rokoter/cv-monitor/docs/jlc_preview_controle_rev0.2.png

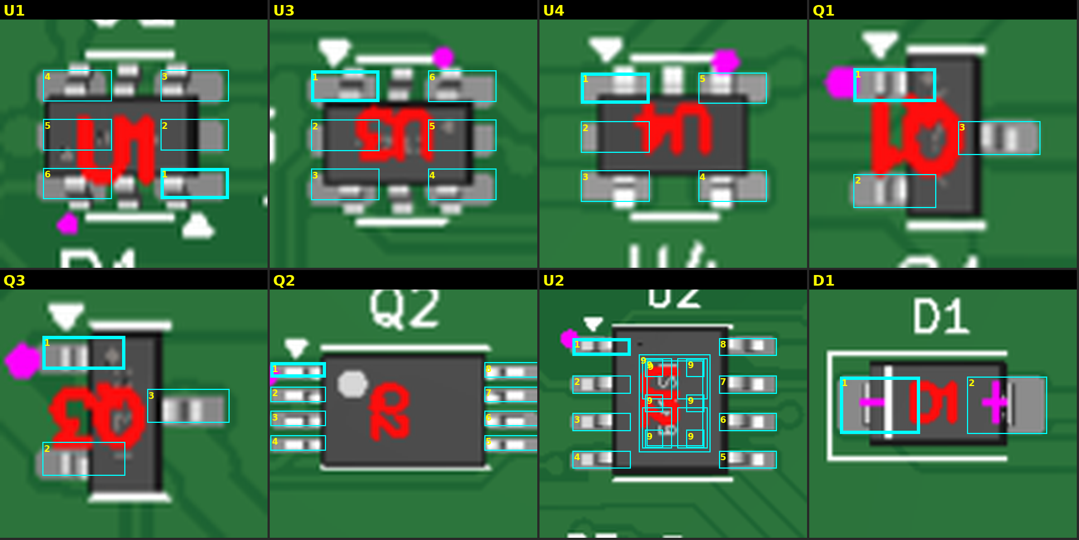
docs/jlc_preview_controle_rev0.2.png
