rokoter/cv-monitor/docs/routing_rapport_rev0.2.txt

net                  lengte   min  via  lagen
VBUS                 152.7mm  0.50    4  B.Cu,F.Cu
EN                   130.6mm  0.20    2  B.Cu,F.Cu
BAT+                 116.5mm  0.80    4  B.Cu,F.Cu
BOOT                 107.0mm  0.20    2  B.Cu,F.Cu
I2C_SCL               94.7mm  0.20    2  B.Cu,F.Cu
I2C_SDA               94.2mm  0.20    4  B.Cu,F.Cu
USB_D+                92.7mm  0.20    4  B.Cu,F.Cu
KNOP                  91.0mm  0.20    2  B.Cu,F.Cu
USB_D-                88.1mm  0.20    4  B.Cu,F.Cu
CELL+                 87.3mm  0.80    1  B.Cu,F.Cu
UART_TX               62.0mm  0.20    0  F.Cu
UART_RX               61.6mm  0.20    2  B.Cu,F.Cu
VSYS                  59.4mm  0.60    0  F.Cu
EXP_GPIO7             49.8mm  0.20    2  B.Cu,F.Cu
DQ_RETOUR             49.8mm  0.20    2  B.Cu,F.Cu
VBAT_SENSE            48.9mm  0.20    2  B.Cu,F.Cu
EXP_GPIO6             46.6mm  0.20    2  B.Cu,F.Cu
TEMP                  44.4mm  0.20    2  B.Cu,F.Cu
DQ_AANVOER            43.4mm  0.20    2  B.Cu,F.Cu
B-                    43.0mm  0.40    1  B.Cu,F.Cu
GND                   41.5mm  0.40   38  B.Cu,F.Cu
EPD_CLK               40.1mm  0.20    0  F.Cu
VBUS_SENSE            34.4mm  0.20    2  B.Cu,F.Cu
Net-(D3-K)            32.0mm  0.20    2  B.Cu,F.Cu
Net-(D2-K)            31.2mm  0.20    2  B.Cu,F.Cu
EPD_BUSY              30.1mm  0.20    1  B.Cu,F.Cu
EPD_RST               27.1mm  0.20    1  B.Cu,F.Cu
EPD_DC                25.6mm  0.20    2  B.Cu,F.Cu
EXP_GPIO18            23.5mm  0.20    0  F.Cu
EXP_GPIO17            22.8mm  0.20    0  F.Cu
EPD_CS                19.6mm  0.20    0  F.Cu
+3V3                  17.2mm  0.40   16  F.Cu
CC1                   15.3mm  0.20    0  F.Cu
Net-(U2-PROG)         15.2mm  0.20    2  B.Cu,F.Cu
VBUS_IN               15.1mm  0.50    0  F.Cu
CC2                   15.1mm  0.20    0  F.Cu
EPD_DIN               14.1mm  0.20    0  F.Cu
DW_VCC                13.1mm  0.20    2  B.Cu,F.Cu
DW_OC                 11.8mm  0.20    0  F.Cu
Net-(J2-Pin_2)        10.7mm  0.20    0  F.Cu
Net-(J3-Pin_2)        10.3mm  0.20    0  F.Cu
LED_STATUS            10.3mm  0.20    0  F.Cu
Net-(D4-A)             8.4mm  0.20    0  F.Cu
Net-(D5-A)             8.0mm  0.20    0  F.Cu
DW_OD                  7.2mm  0.20    0  F.Cu
unconnected-(Q2-D-Pad1)     5.7mm  0.20    0  F.Cu
Net-(Q3-G)             5.6mm  0.20    0  F.Cu
DW_CS                  5.1mm  0.20    0  F.Cu
Net-(D6-K)             4.8mm  0.20    0  F.Cu
Net-(D2-A)             4.6mm  0.20    0  F.Cu
Net-(D3-A)             4.6mm  0.20    0  F.Cu
Net-(JP1-A)            2.5mm  0.20    0  F.Cu

112 via's, 2096 mm spoor
info: VSYS: 0.60 mm over 1.8 mm (versmalling bij pin)
info: VSYS: 0.60 mm over 1.8 mm (versmalling bij pin)
info: VSYS: 0.60 mm over 0.0 mm (versmalling bij pin)
info: VSYS: 0.60 mm over 0.1 mm (versmalling bij pin)
info: VBUS: 0.60 mm over 0.5 mm (versmalling bij pin)
info: VBUS: 0.60 mm over 0.9 mm (versmalling bij pin)
info: VBUS: 0.50 mm over 1.0 mm (versmalling bij pin)
CONTROLE: in orde
