rokoter/cv-monitor/docs/gerber_controle_boven_rev0.2.png

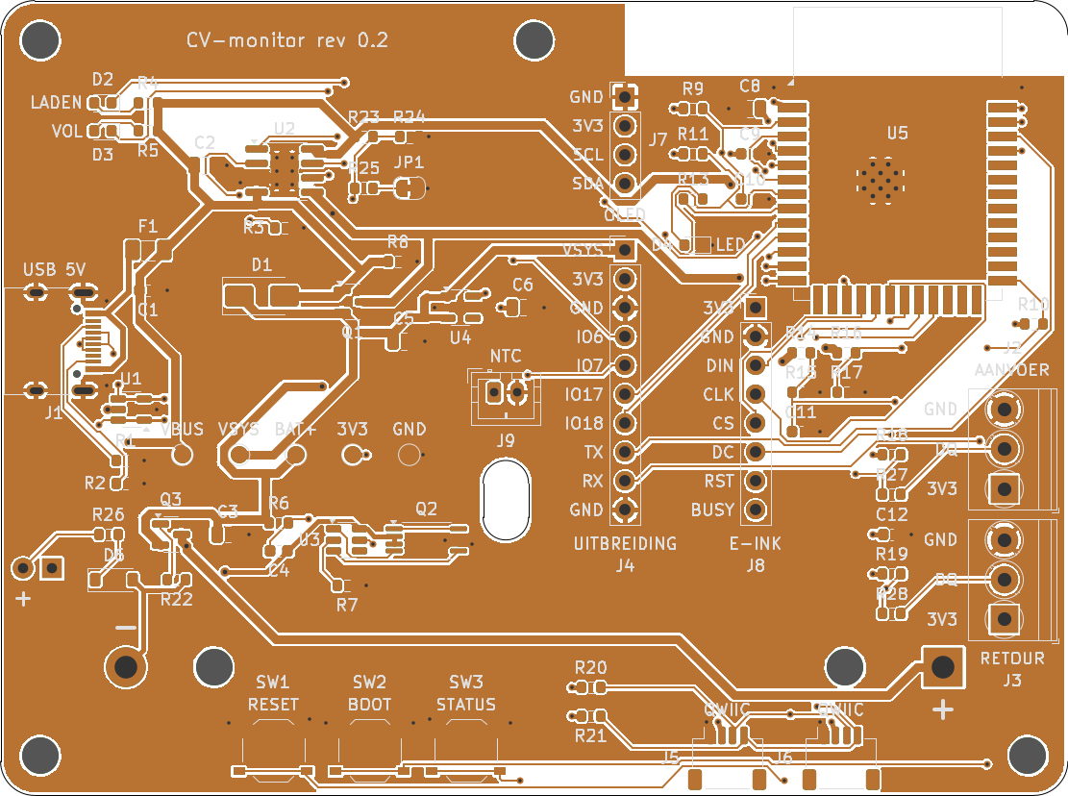
docs/gerber_controle_boven_rev0.2.png
