rokoter/cv-monitor/docs/gerber_controle_onder_rev0.2.png

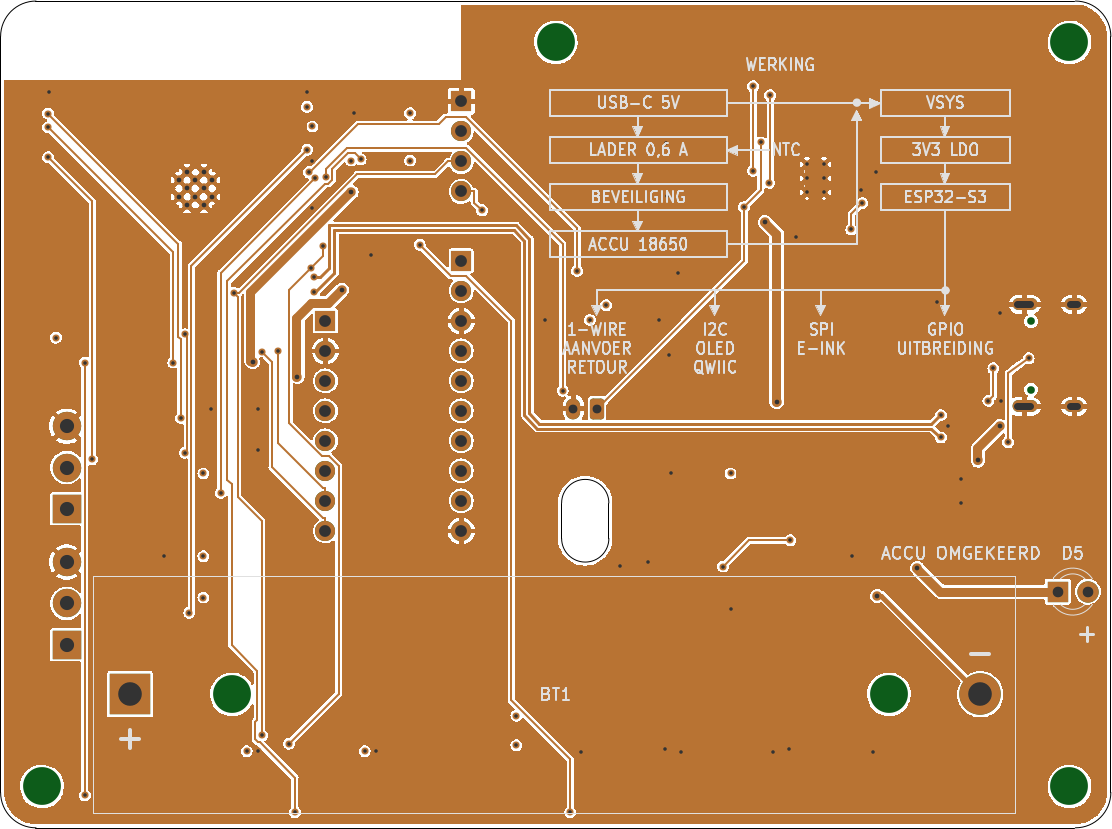
docs/gerber_controle_onder_rev0.2.png
