rokoter/cv-monitor/docs/pcb_3d_boven_rev0.2.png

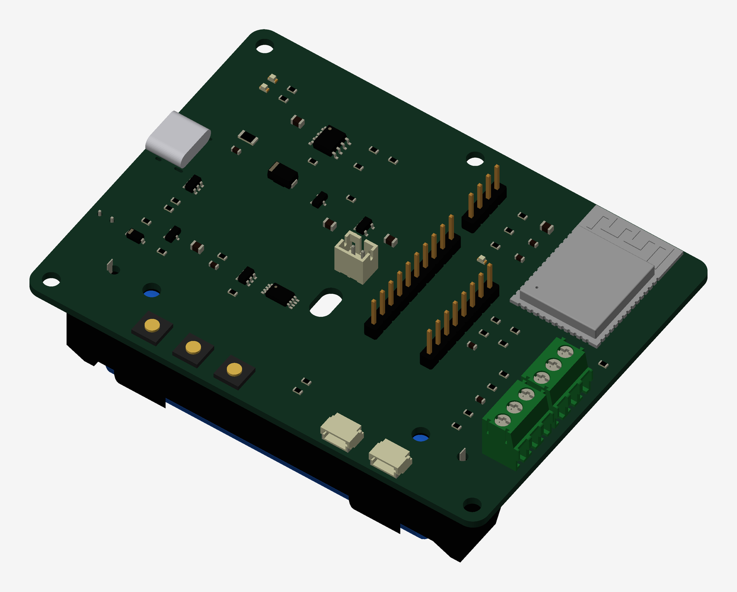
docs/pcb_3d_boven_rev0.2.png
