rokoter/cv-monitor/docs/pcb_3d_onder_rev0.2.png

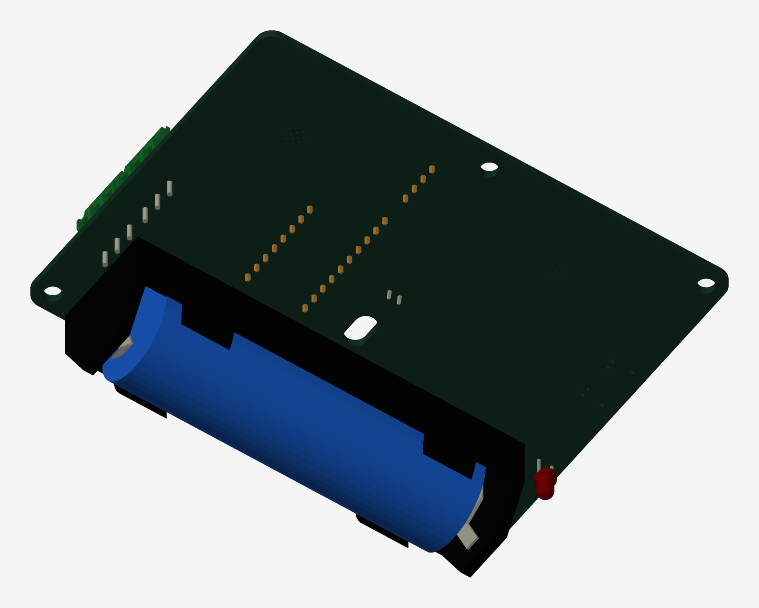
docs/pcb_3d_onder_rev0.2.png
