rokoter/cv-monitor/docs/pcb_achterkant_blokschema_rev0.2.png

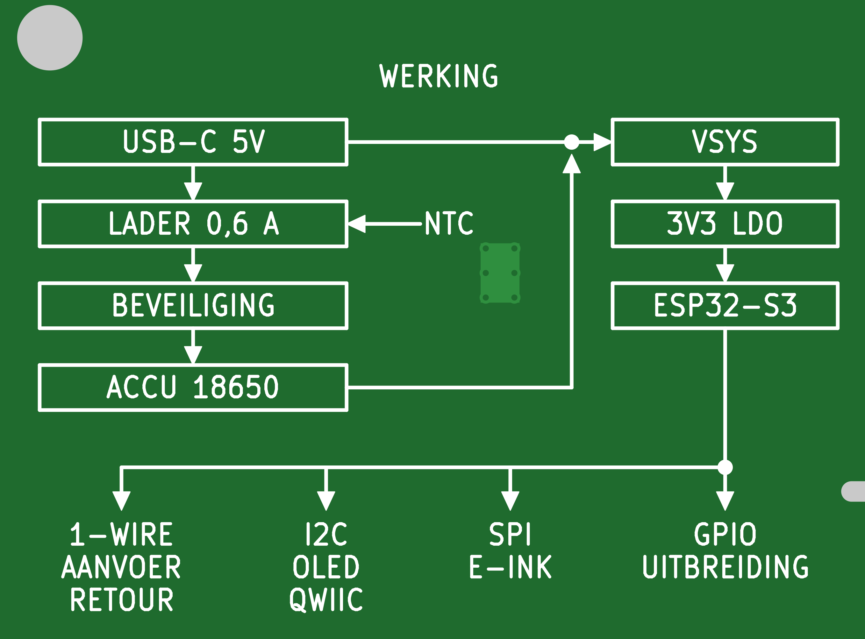
docs/pcb_achterkant_blokschema_rev0.2.png
