rokoter/cv-monitor/docs/pcb_plaatsing_rev0.2.png

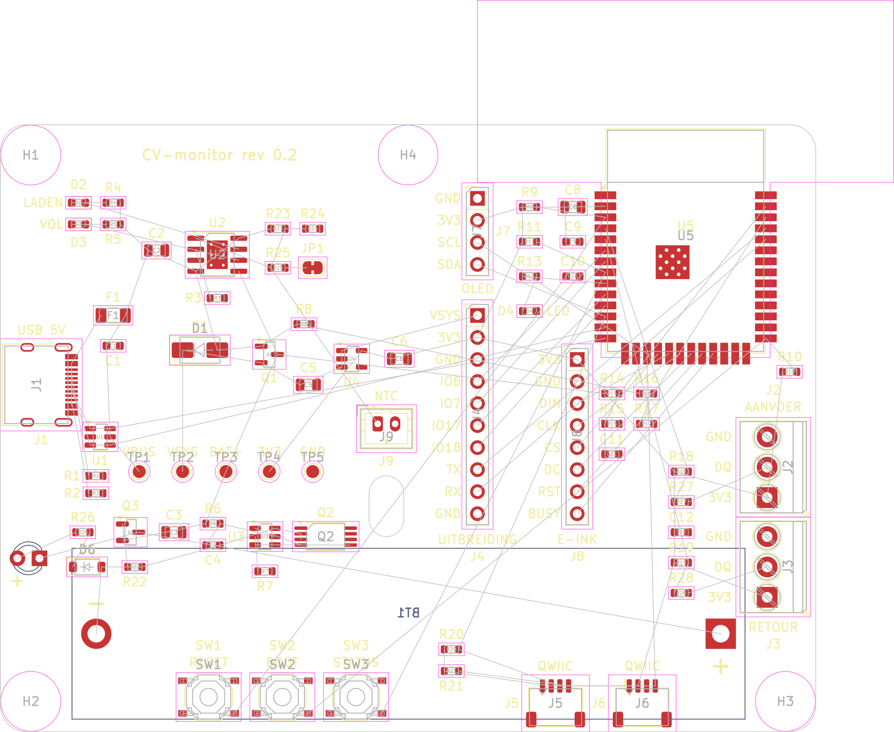
docs/pcb_plaatsing_rev0.2.png
