rokoter/cv-monitor/docs/pcb_preview_boven_rev0.2.png

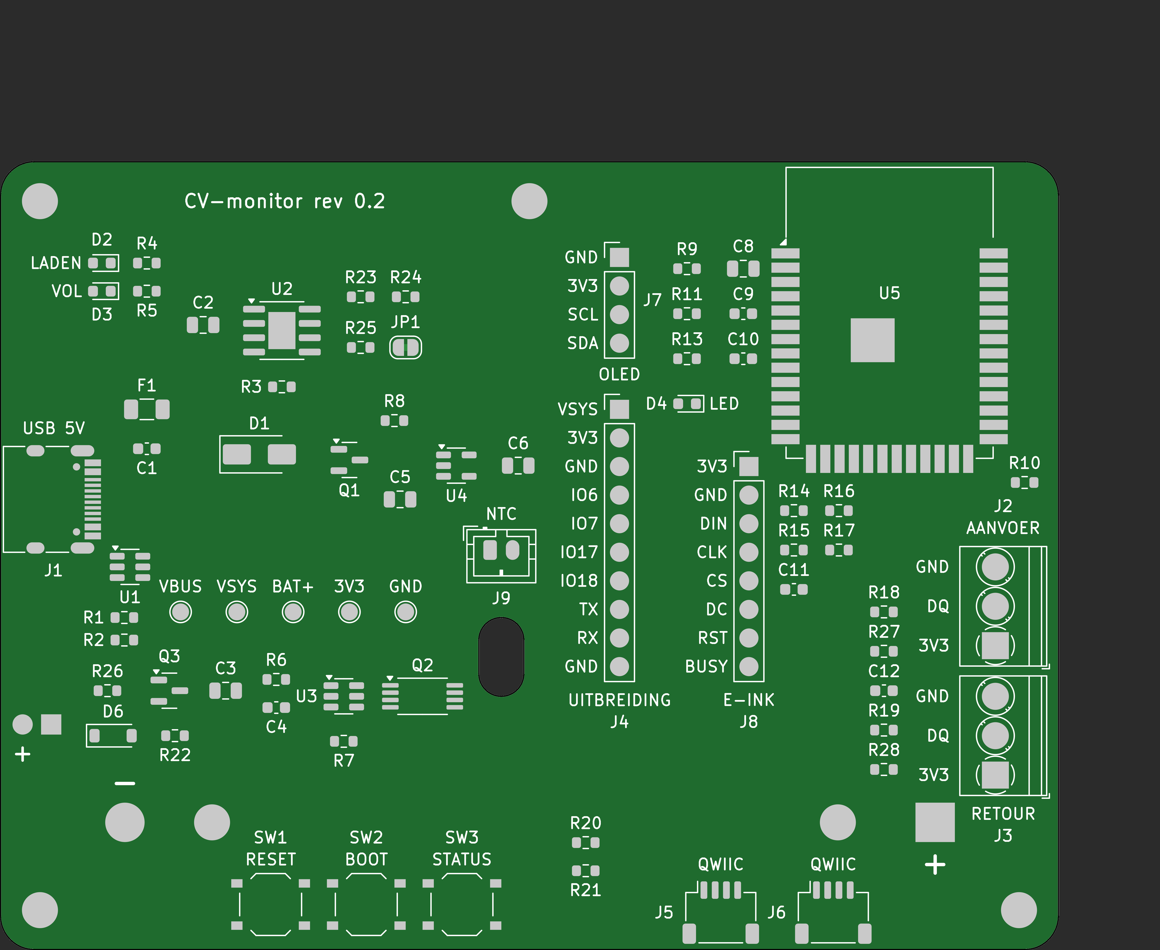
docs/pcb_preview_boven_rev0.2.png
