rokoter/cv-monitor/docs/pcb_preview_onder_rev0.2.png

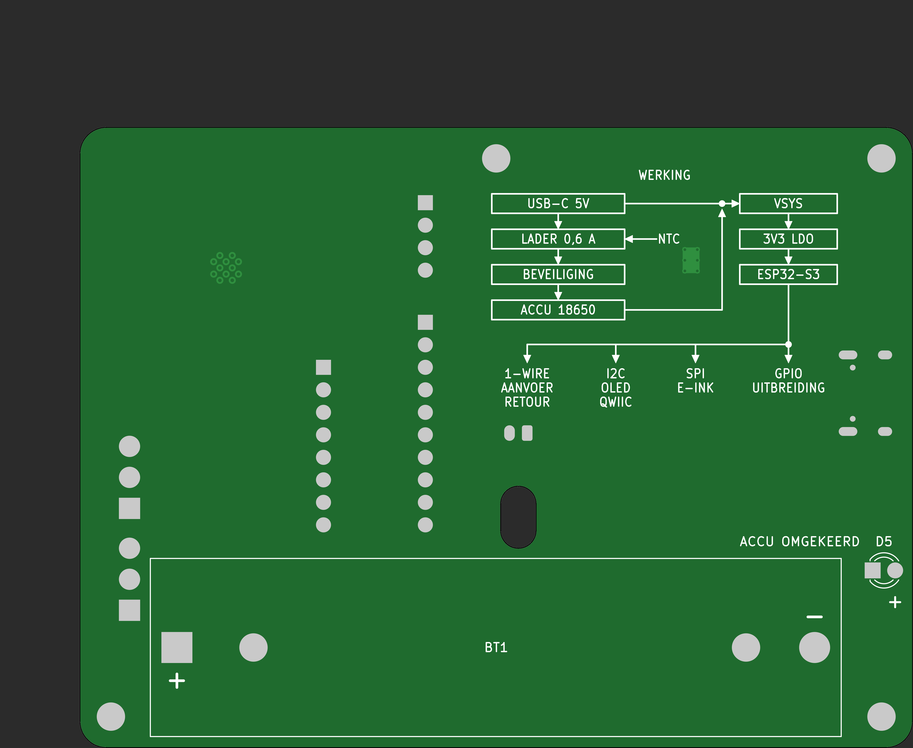
docs/pcb_preview_onder_rev0.2.png
