rokoter/cv-monitor/docs/pcb_routing_boven_rev0.2.png

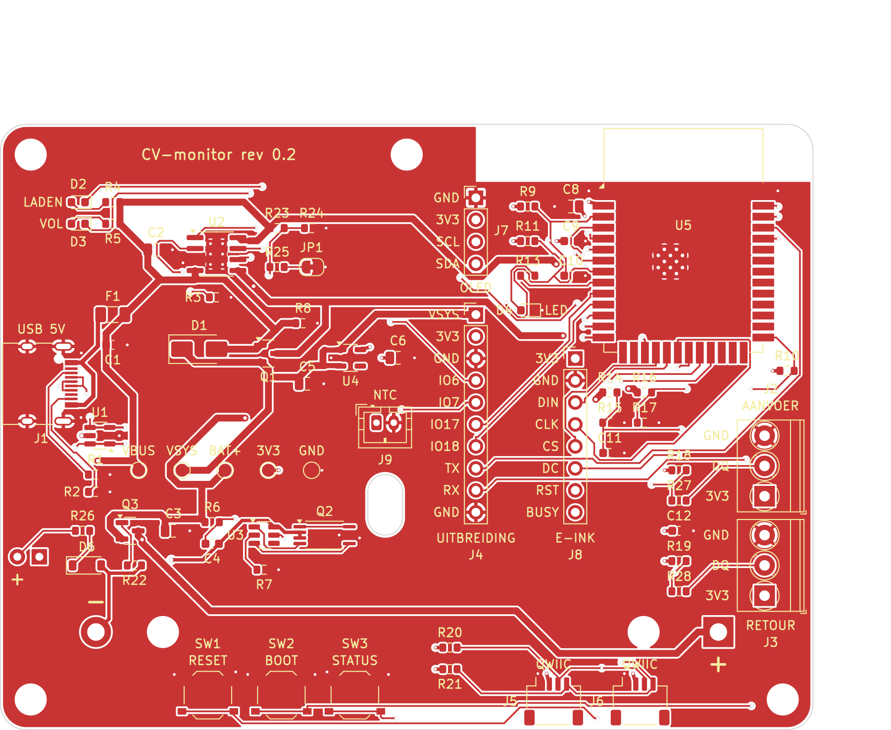
docs/pcb_routing_boven_rev0.2.png
