rokoter/cv-monitor/docs/pcb_routing_in1_gnd_rev0.2.png

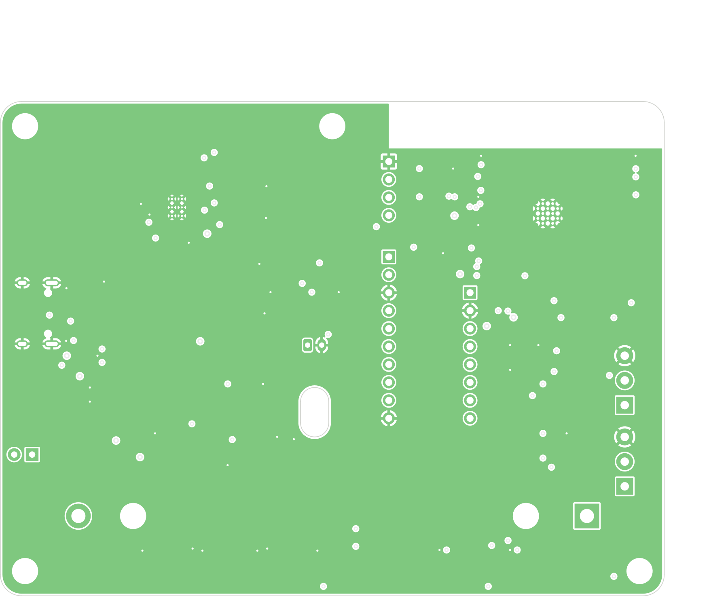
docs/pcb_routing_in1_gnd_rev0.2.png
