rokoter/cv-monitor/docs/pcb_routing_in2_3v3_rev0.2.png

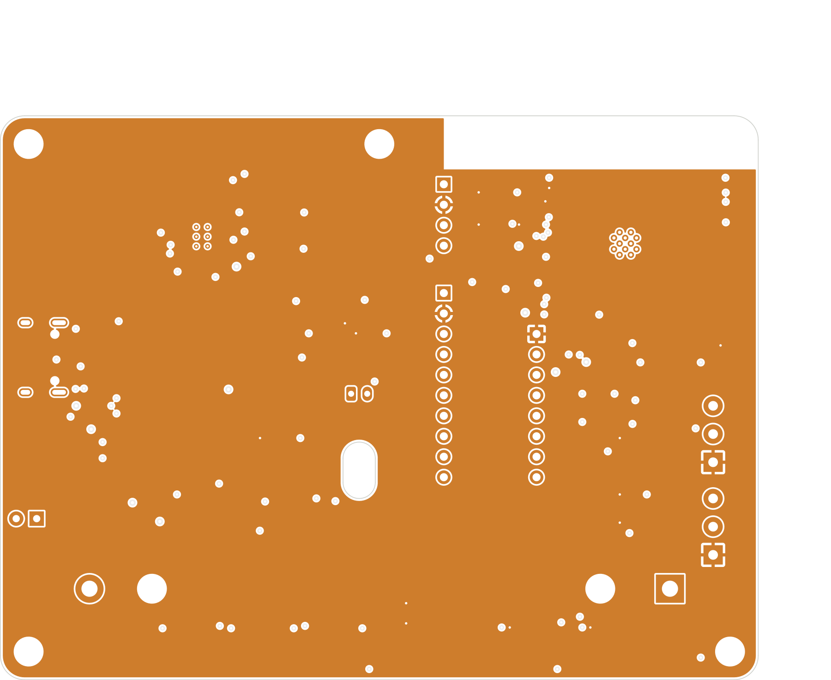
docs/pcb_routing_in2_3v3_rev0.2.png
