rokoter/cv-monitor/docs/pcb_usb_paar_onderkant_rev0.2.png

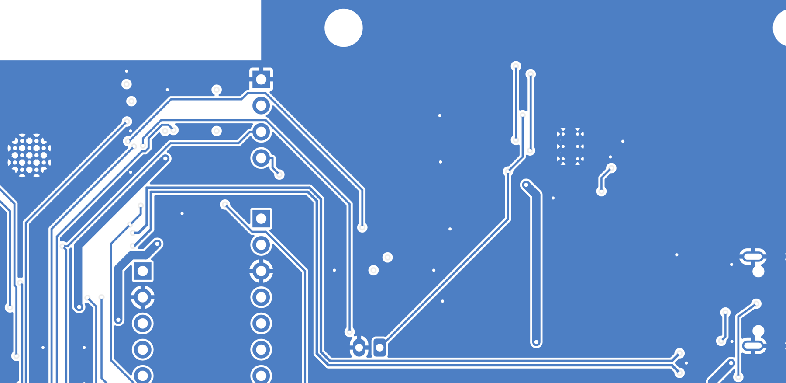
docs/pcb_usb_paar_onderkant_rev0.2.png
