rokoter/cv-monitor/hardware/cv_monitor/production/cv_monitor_rev0.2_bom.csv

Comment | Designator | Footprint | LCSC Part #
1uF | C1,C10 | C_0603_1608Metric | C15849
10uF | C2,C3,C5,C6 | C_0805_2012Metric | C15850
100nF | C4,C9,C11,C12 | C_0603_1608Metric | C14663
22uF | C8 | C_0805_2012Metric | C45783
SS34 | D1 | D_SMA | C8678
rood: laden | D2 | LED_0603_1608Metric | C2286
groen: vol | D3 | LED_0603_1608Metric | C12624
geel: status | D4 | LED_0603_1608Metric | C89811
1N4148W | D6 | D_SOD-123 | C81598
1,1A PTC | F1 | Fuse_1206_3216Metric | C269119
USB-C | J1 | USB_C_Receptacle_HRO_TYPE-C-31-M-12 | C165948
QWIIC 1 / QWIIC 2 | J5,J6 | JST_SH_SM04B-SRSS-TB_1x04-1MP_P1.00mm_Horizontal | C160404
AO3401A | Q1,Q3 | SOT-23 | C15127
AO8810 (8205A-compatibel) | Q2 | TSSOP-8_4.4x3mm_P0.65mm | C21426
5.1k | R1,R2 | R_0603_1608Metric | C23186
2k | R3 | R_0603_1608Metric | C22975
1k | R4,R7,R8,R13,R26 | R_0603_1608Metric | C21190
4.7k | R5,R18,R19,R20,R21,R23 | R_0603_1608Metric | C23162
100R | R6,R27,R28 | R_0603_1608Metric | C22775
10k | R9,R10,R11,R22,R25 | R_0603_1608Metric | C25804
100k | R14,R15,R16,R17 | R_0603_1608Metric | C25803
47k | R24 | R_0603_1608Metric | C25819
RESET / BOOT / STATUS | SW1,SW2,SW3 | SW_Push_1P1T_XKB_TS-1187A | C318884
USBLC6-2SC6 | U1 | SOT-23-6 | C7519
TP4056 | U2 | SOIC-8-1EP_3.9x4.9mm_P1.27mm_EP2.41x3.3mm_ThermalVias_0.3mm | C16581
DW01A | U3 | SOT-23-6 | C351410
AP2112K-3.3 | U4 | SOT-23-5 | C51118
