rokoter/cv-monitor/hardware/cv_monitor/3dmodels/SOT-23-5.step

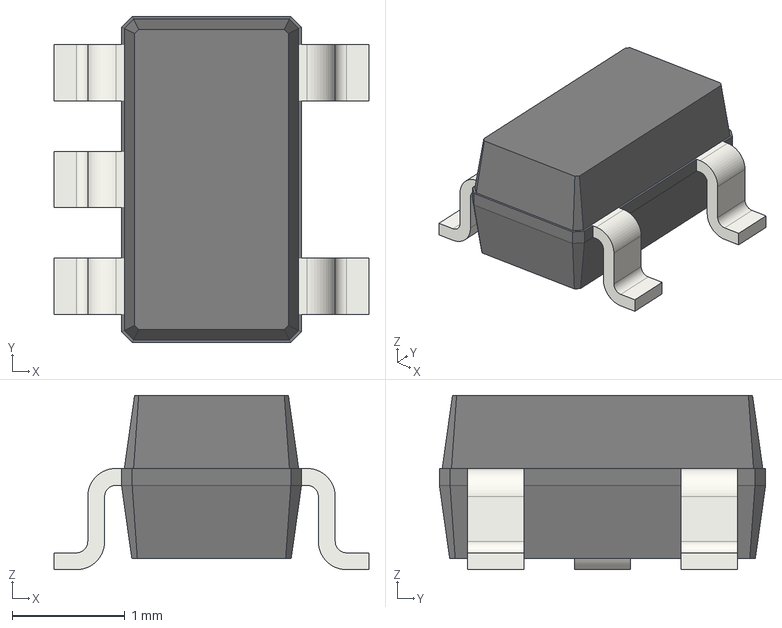
[picture p15: CAD file, 2026-11-10]
hardware/cv_monitor/3dmodels/SOT-23-5.step
2.80 x 2.90 x 1.55 mm
