rokoter/cv-monitor/hardware/cv_monitor/3dmodels/C_0805_2012Metric.step

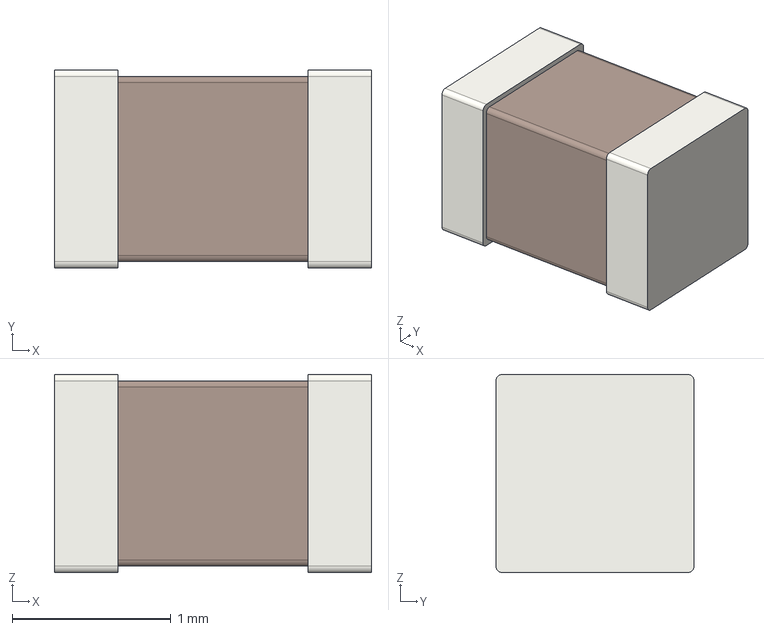
[picture p16: CAD file, 2026-11-10]
hardware/cv_monitor/3dmodels/C_0805_2012Metric.step
2.00 x 1.25 x 1.25 mm
