rokoter/cv-monitor/hardware/cv_monitor/3dmodels/Cell_18650.step

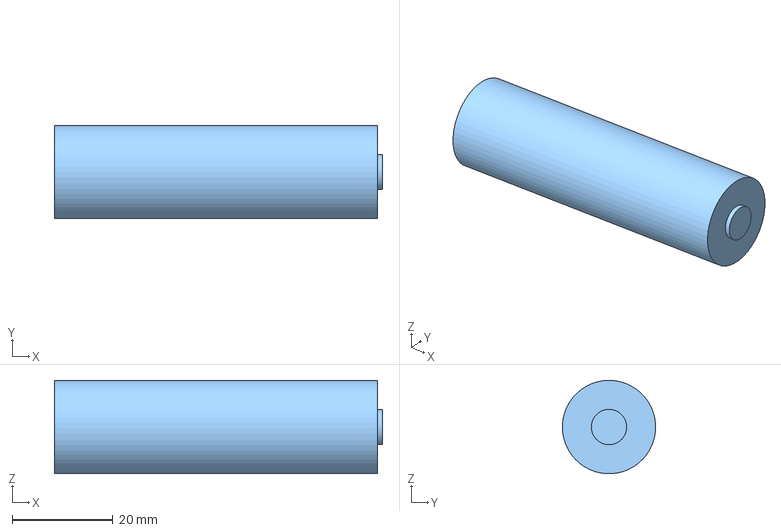
[picture p17: CAD file, 2026-11-10]
hardware/cv_monitor/3dmodels/Cell_18650.step
65.0 x 18.5 x 18.5 mm
