rokoter/cv-monitor/hardware/cv_monitor/3dmodels/R_0603_1608Metric.step

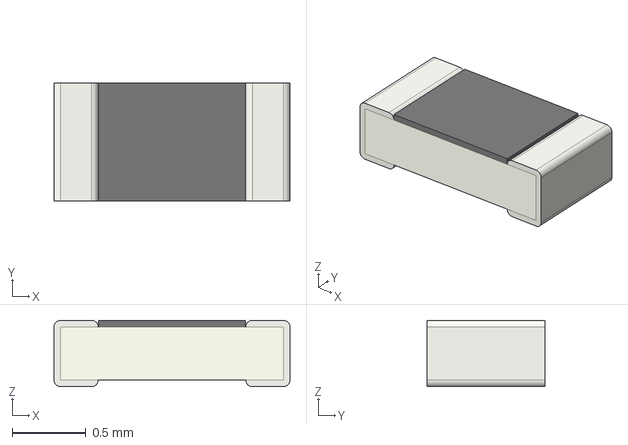
[picture p19: CAD file, 2026-11-10]
hardware/cv_monitor/3dmodels/R_0603_1608Metric.step
1.60 x 0.8 x 0.45 mm
