rokoter/cv-monitor/hardware/cv_monitor/3dmodels/SOIC-8-1EP_3.9x4.9mm_P1.27mm_EP2.35x2.35mm.step

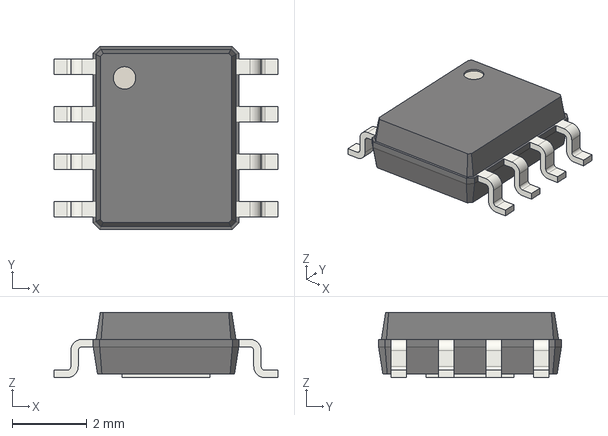
[picture p20: CAD file, 2026-11-10]
hardware/cv_monitor/3dmodels/SOIC-8-1EP_3.9x4.9mm_P1.27mm_EP2.35x2.35mm.step
6.00 x 4.90 x 1.75 mm
