rokoter/cv-monitor/hardware/cv_monitor/3dmodels/D_SOD-123.step

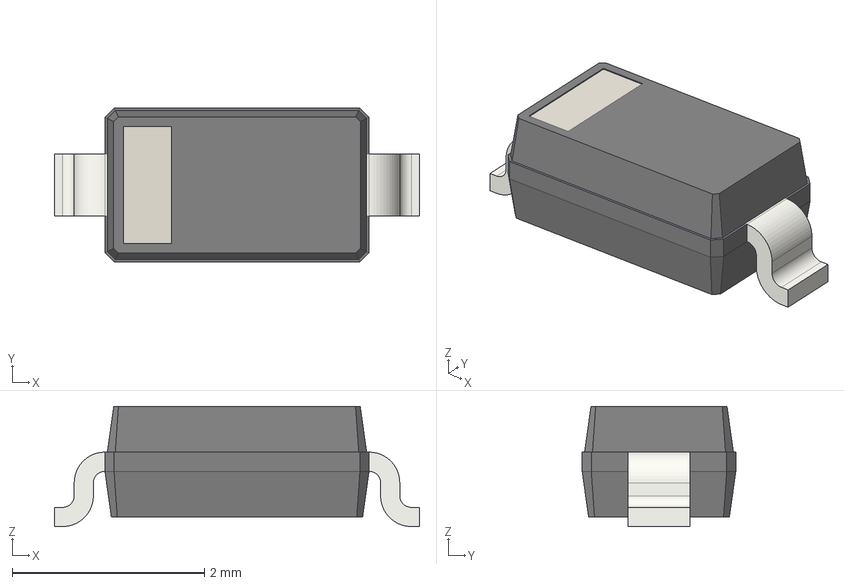
[picture p21: CAD file, 2026-11-10]
hardware/cv_monitor/3dmodels/D_SOD-123.step
3.80 x 1.60 x 1.25 mm
