rokoter/cv-monitor/hardware/cv_monitor/3dmodels/C_0603_1608Metric.step

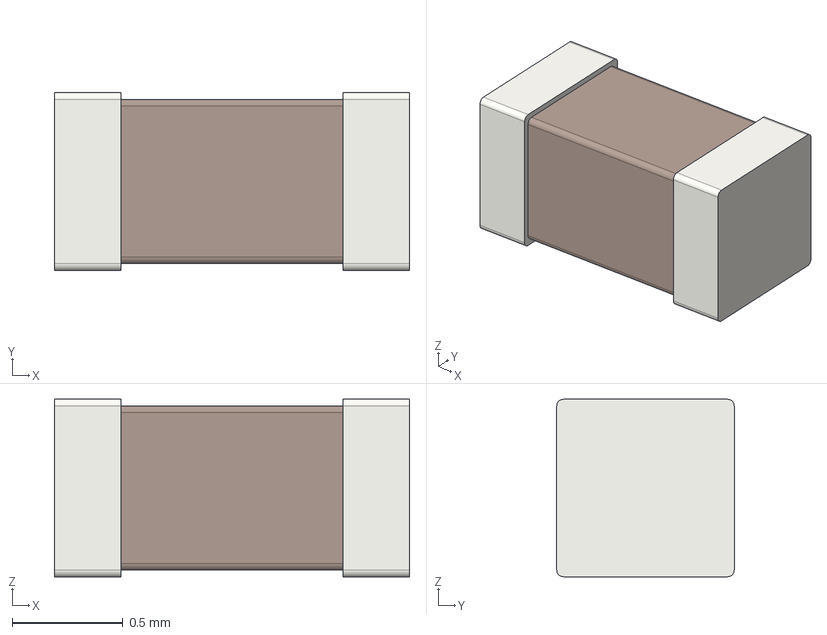
[picture p22: CAD file, 2026-11-10]
hardware/cv_monitor/3dmodels/C_0603_1608Metric.step
1.60 x 0.8 x 0.8 mm
