rokoter/cv-monitor/hardware/cv_monitor/3dmodels/LED_D3.0mm.step

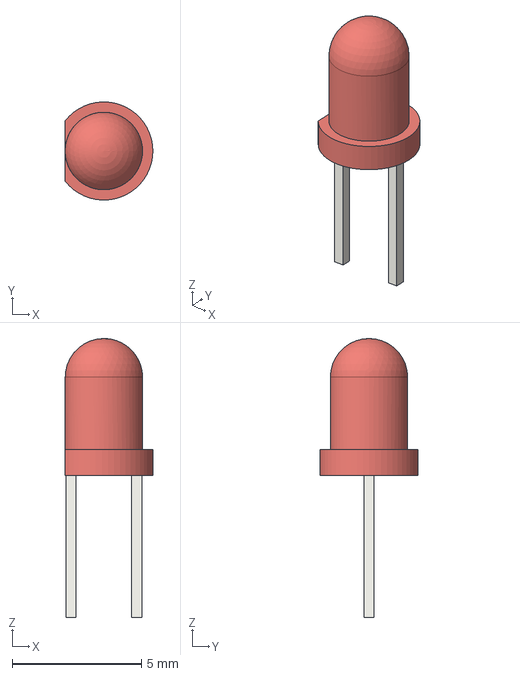
[picture p23: CAD file, 2026-11-10]
hardware/cv_monitor/3dmodels/LED_D3.0mm.step
3.40 x 3.80 x 10.8 mm
