rokoter/cv-monitor/hardware/cv_monitor/3dmodels/USB_C_Receptacle_HRO_TYPE-C-31-M-12.step

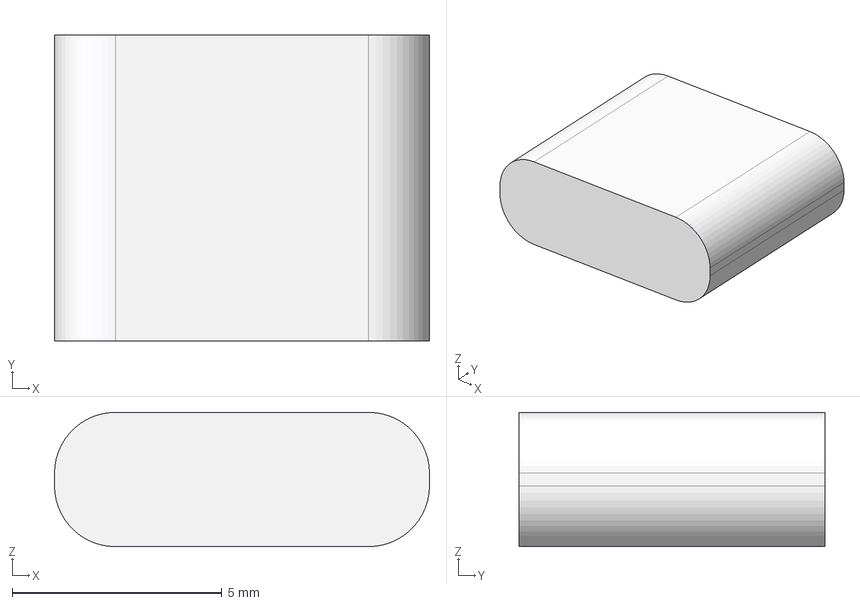
[picture p24: CAD file, 2026-11-10]
hardware/cv_monitor/3dmodels/USB_C_Receptacle_HRO_TYPE-C-31-M-12.step
8.94 x 7.30 x 3.20 mm
