rokoter/cv-monitor/hardware/cv_monitor/3dmodels/ESP32-S3-WROOM-1.step

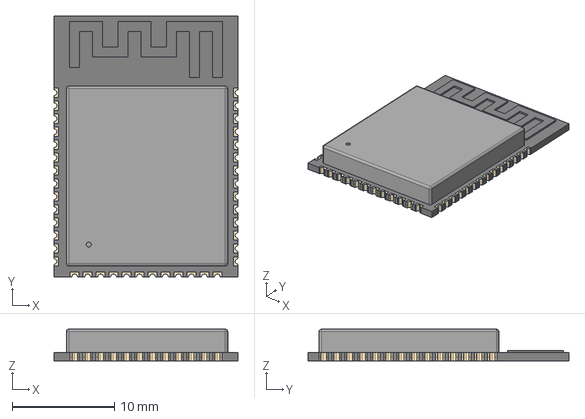
[picture p25: CAD file, 2026-11-10]
hardware/cv_monitor/3dmodels/ESP32-S3-WROOM-1.step
18.0 x 25.5 x 3.10 mm
