rokoter/cv-monitor/hardware/cv_monitor/3dmodels/PinHeader_1x08_P2.54mm_Vertical.step

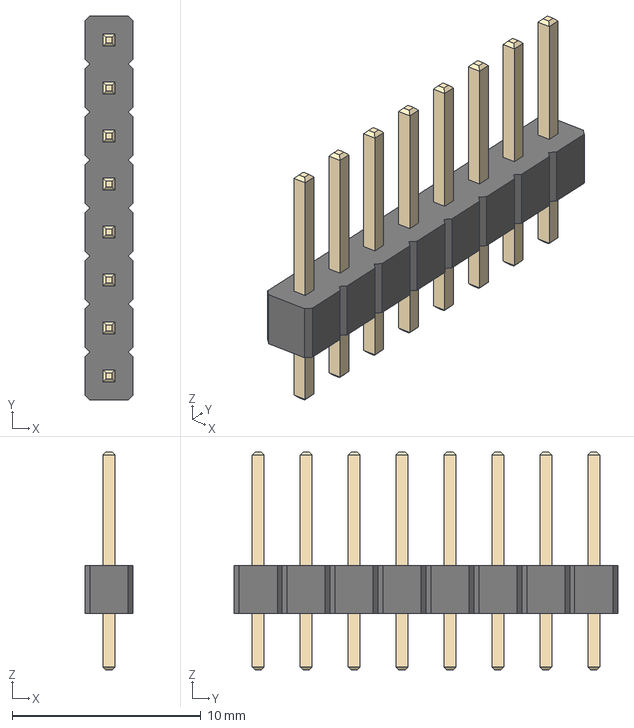
[picture p26: CAD file, 2026-11-10]
hardware/cv_monitor/3dmodels/PinHeader_1x08_P2.54mm_Vertical.step
2.54 x 20.3 x 11.5 mm
