rokoter/cv-monitor/hardware/cv_monitor/3dmodels/SW_Push_1P1T_XKB_TS-1187A.step

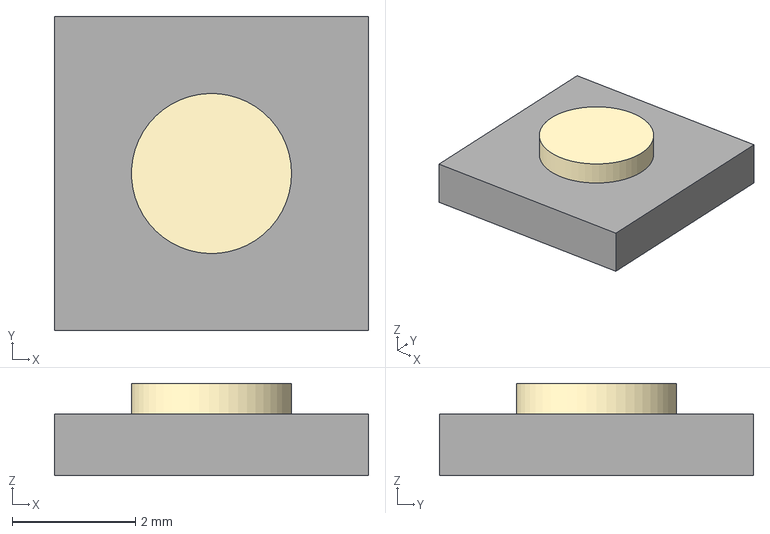
[picture p27: CAD file, 2026-11-10]
hardware/cv_monitor/3dmodels/SW_Push_1P1T_XKB_TS-1187A.step
5.10 x 5.10 x 1.50 mm
