rokoter/cv-monitor/hardware/cv_monitor/3dmodels/BatteryHolder_MPD_BH-18650-PC2.step

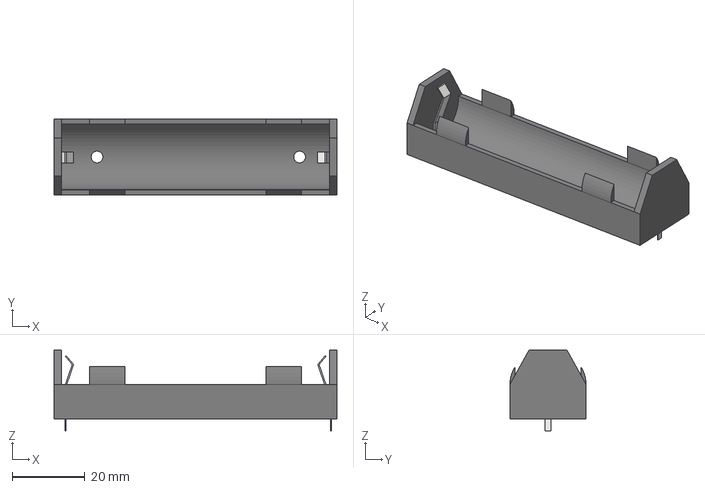
[picture p28: CAD file, 2026-11-10]
hardware/cv_monitor/3dmodels/BatteryHolder_MPD_BH-18650-PC2.step
77.7 x 20.9 x 22.2 mm
