rokoter/cv-monitor/hardware/cv_monitor/3dmodels/PinHeader_1x10_P2.54mm_Vertical.step

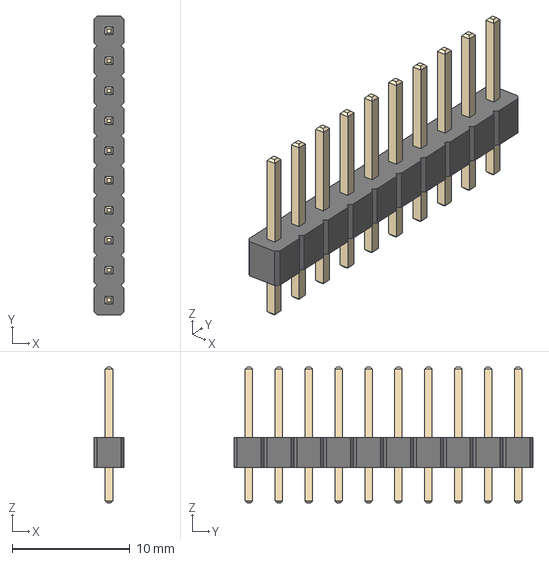
[picture p29: CAD file, 2026-11-10]
hardware/cv_monitor/3dmodels/PinHeader_1x10_P2.54mm_Vertical.step
2.54 x 25.4 x 11.5 mm
