rokoter/cv-monitor/hardware/cv_monitor/3dmodels/JST_PH_B2B-PH-K_1x02_P2.00mm_Vertical.step

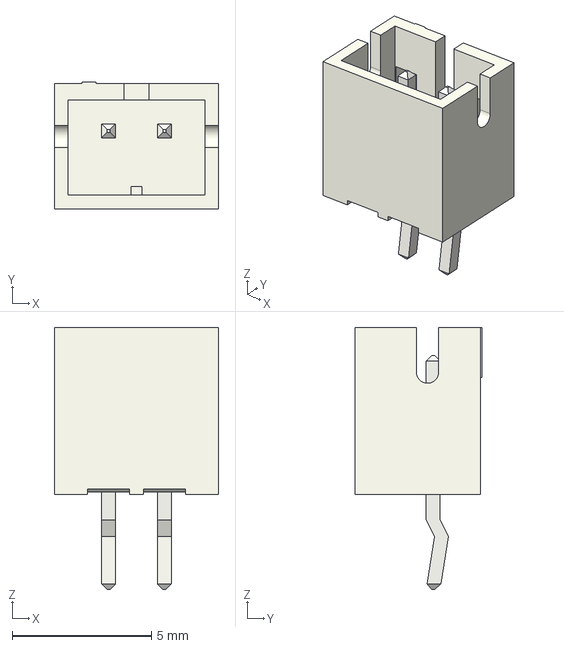
[picture p31: CAD file, 2026-11-10]
hardware/cv_monitor/3dmodels/JST_PH_B2B-PH-K_1x02_P2.00mm_Vertical.step
5.90 x 4.55 x 9.40 mm
