rokoter/cv-monitor/hardware/cv_monitor/3dmodels/TerminalBlock_Phoenix_PT-1,5-3-3.5-H_1x03_P3.50mm_Horizontal.step

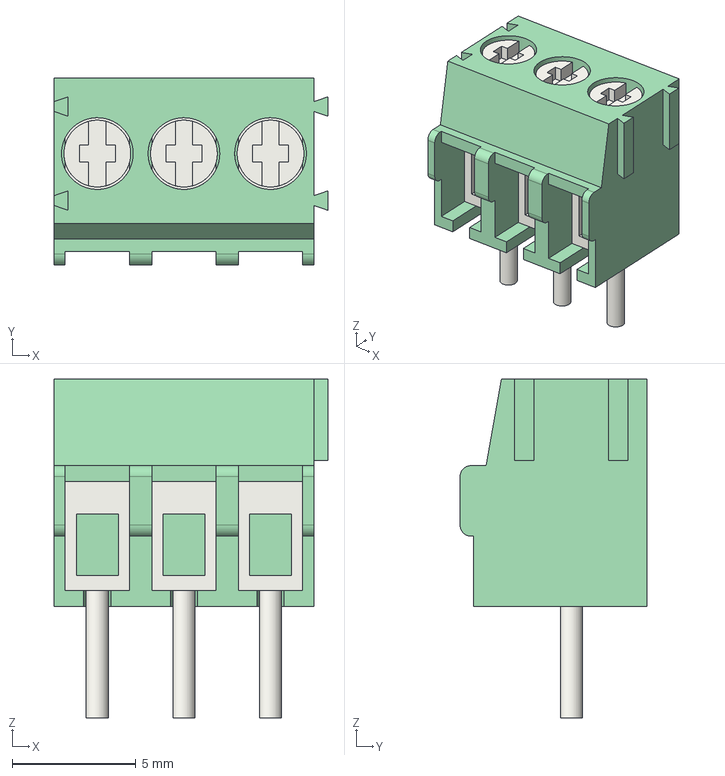
[picture p32: CAD file, 2026-11-10]
hardware/cv_monitor/3dmodels/TerminalBlock_Phoenix_PT-1,5-3-3.5-H_1x03_P3.50mm_Horizontal.step
11.1 x 7.55 x 13.7 mm
