rokoter/cv-monitor/hardware/cv_monitor/3dmodels/PinHeader_1x04_P2.54mm_Vertical.step

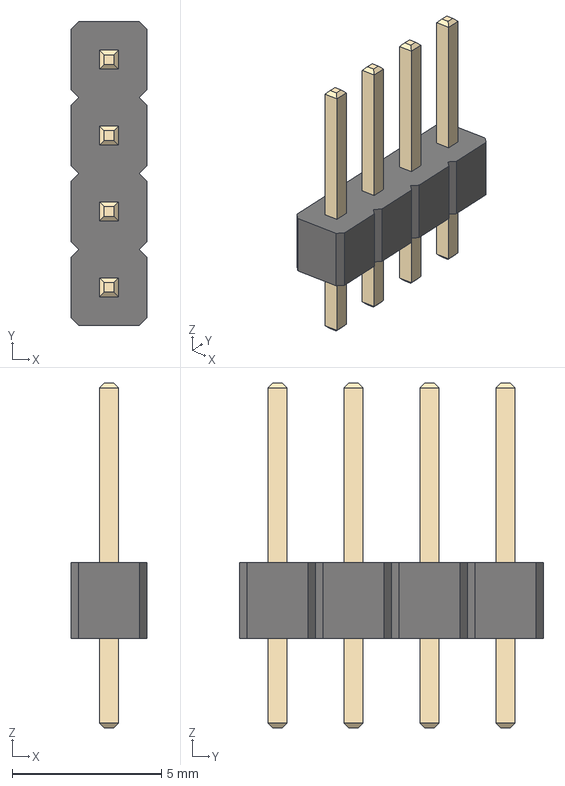
[picture p33: CAD file, 2026-11-10]
hardware/cv_monitor/3dmodels/PinHeader_1x04_P2.54mm_Vertical.step
2.54 x 10.2 x 11.5 mm
