rokoter/cv-monitor/hardware/cv_monitor/3dmodels/SOT-23.step

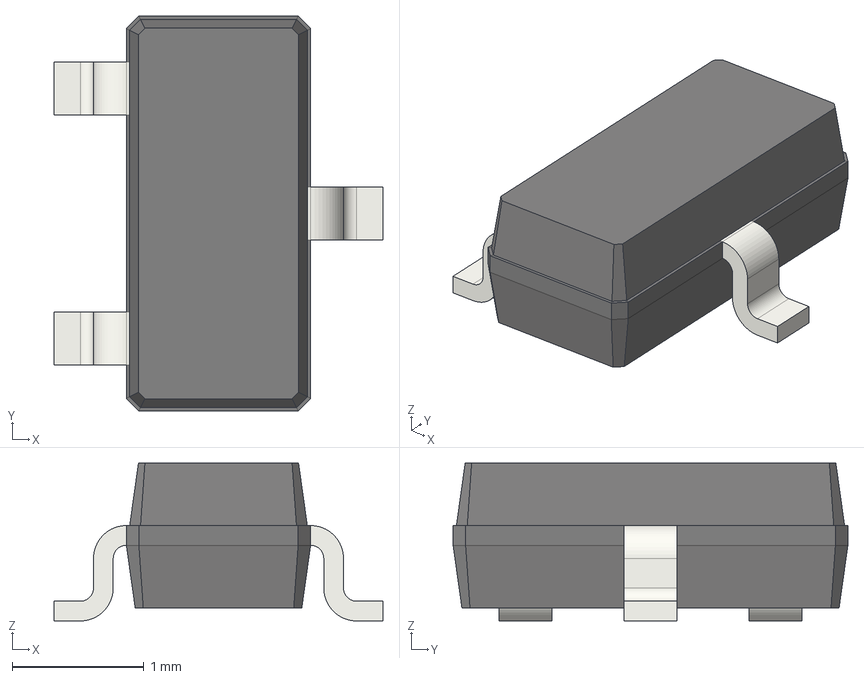
[picture p34: CAD file, 2026-11-10]
hardware/cv_monitor/3dmodels/SOT-23.step
2.50 x 3.00 x 1.20 mm
