rokoter/cv-monitor/hardware/cv_monitor/3dmodels/JST_SH_SM04B-SRSS-TB_1x04-1MP_P1.00mm_Horizontal.step

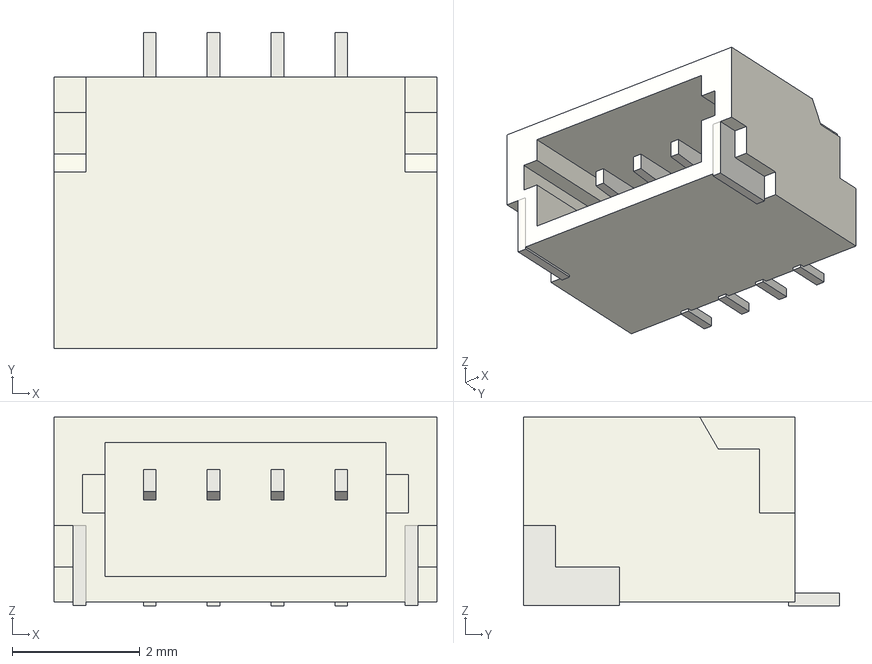
[picture p35: CAD file, 2026-11-10]
hardware/cv_monitor/3dmodels/JST_SH_SM04B-SRSS-TB_1x04-1MP_P1.00mm_Horizontal.step
6.00 x 4.95 x 2.96 mm
