rokoter/cv-monitor/hardware/cv_monitor/3dmodels/D_SMA.step

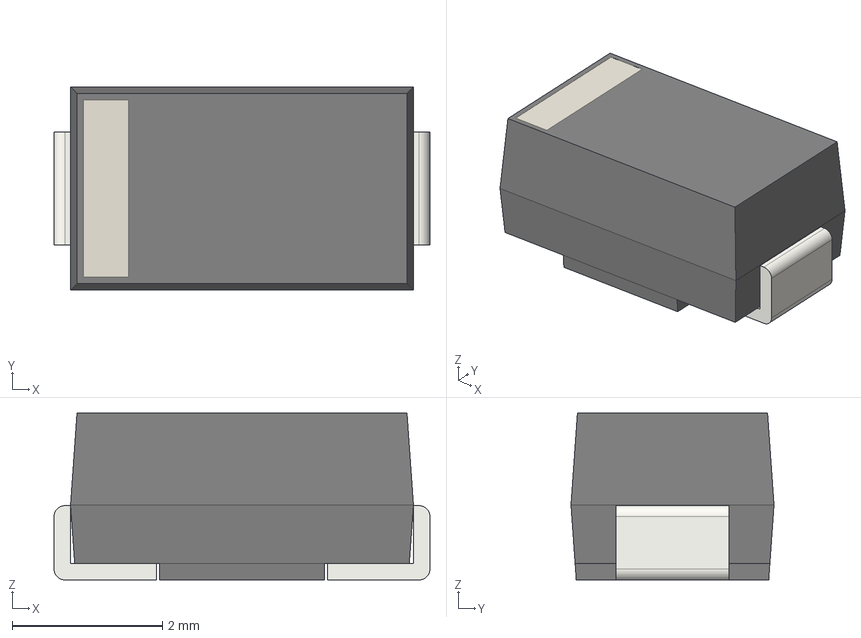
[picture p36: CAD file, 2026-11-10]
hardware/cv_monitor/3dmodels/D_SMA.step
5.00 x 2.70 x 2.22 mm
