rokoter/cv-monitor/hardware/cv_monitor/3dmodels/TSSOP-8_4.4x3mm_P0.65mm.step

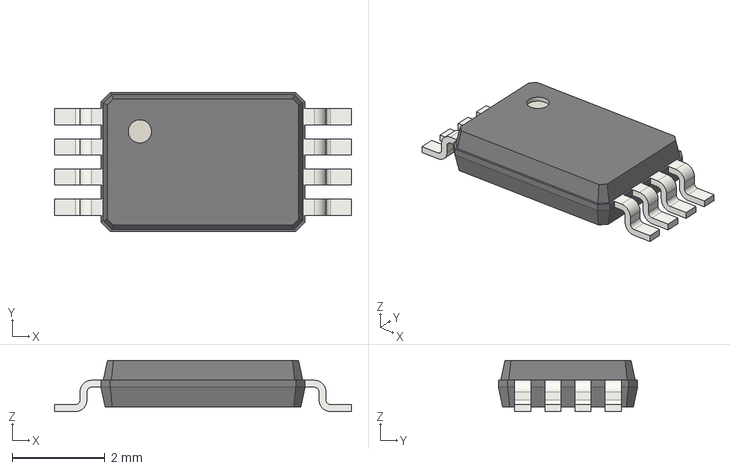
[picture p37: CAD file, 2026-11-10]
hardware/cv_monitor/3dmodels/TSSOP-8_4.4x3mm_P0.65mm.step
6.40 x 3.00 x 1.10 mm
