rokoter/cv-monitor/hardware/cv_monitor/3dmodels/Fuse_1206_3216Metric.step

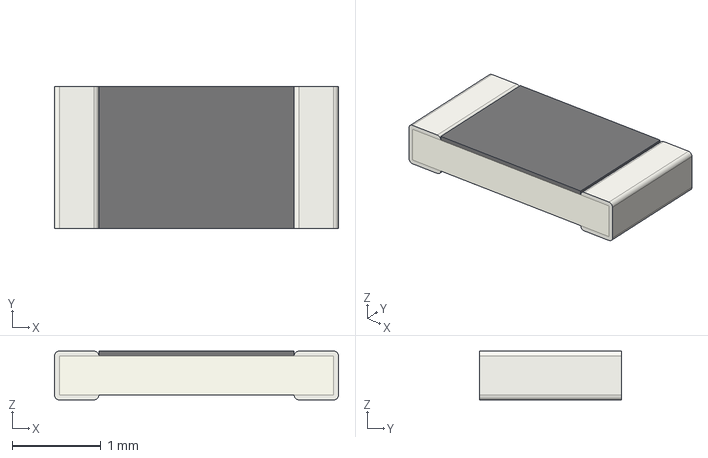
[picture p38: CAD file, 2026-11-10]
hardware/cv_monitor/3dmodels/Fuse_1206_3216Metric.step
3.20 x 1.60 x 0.55 mm
