rokoter/cv-monitor/docs/cv_monitor_schema.pdf

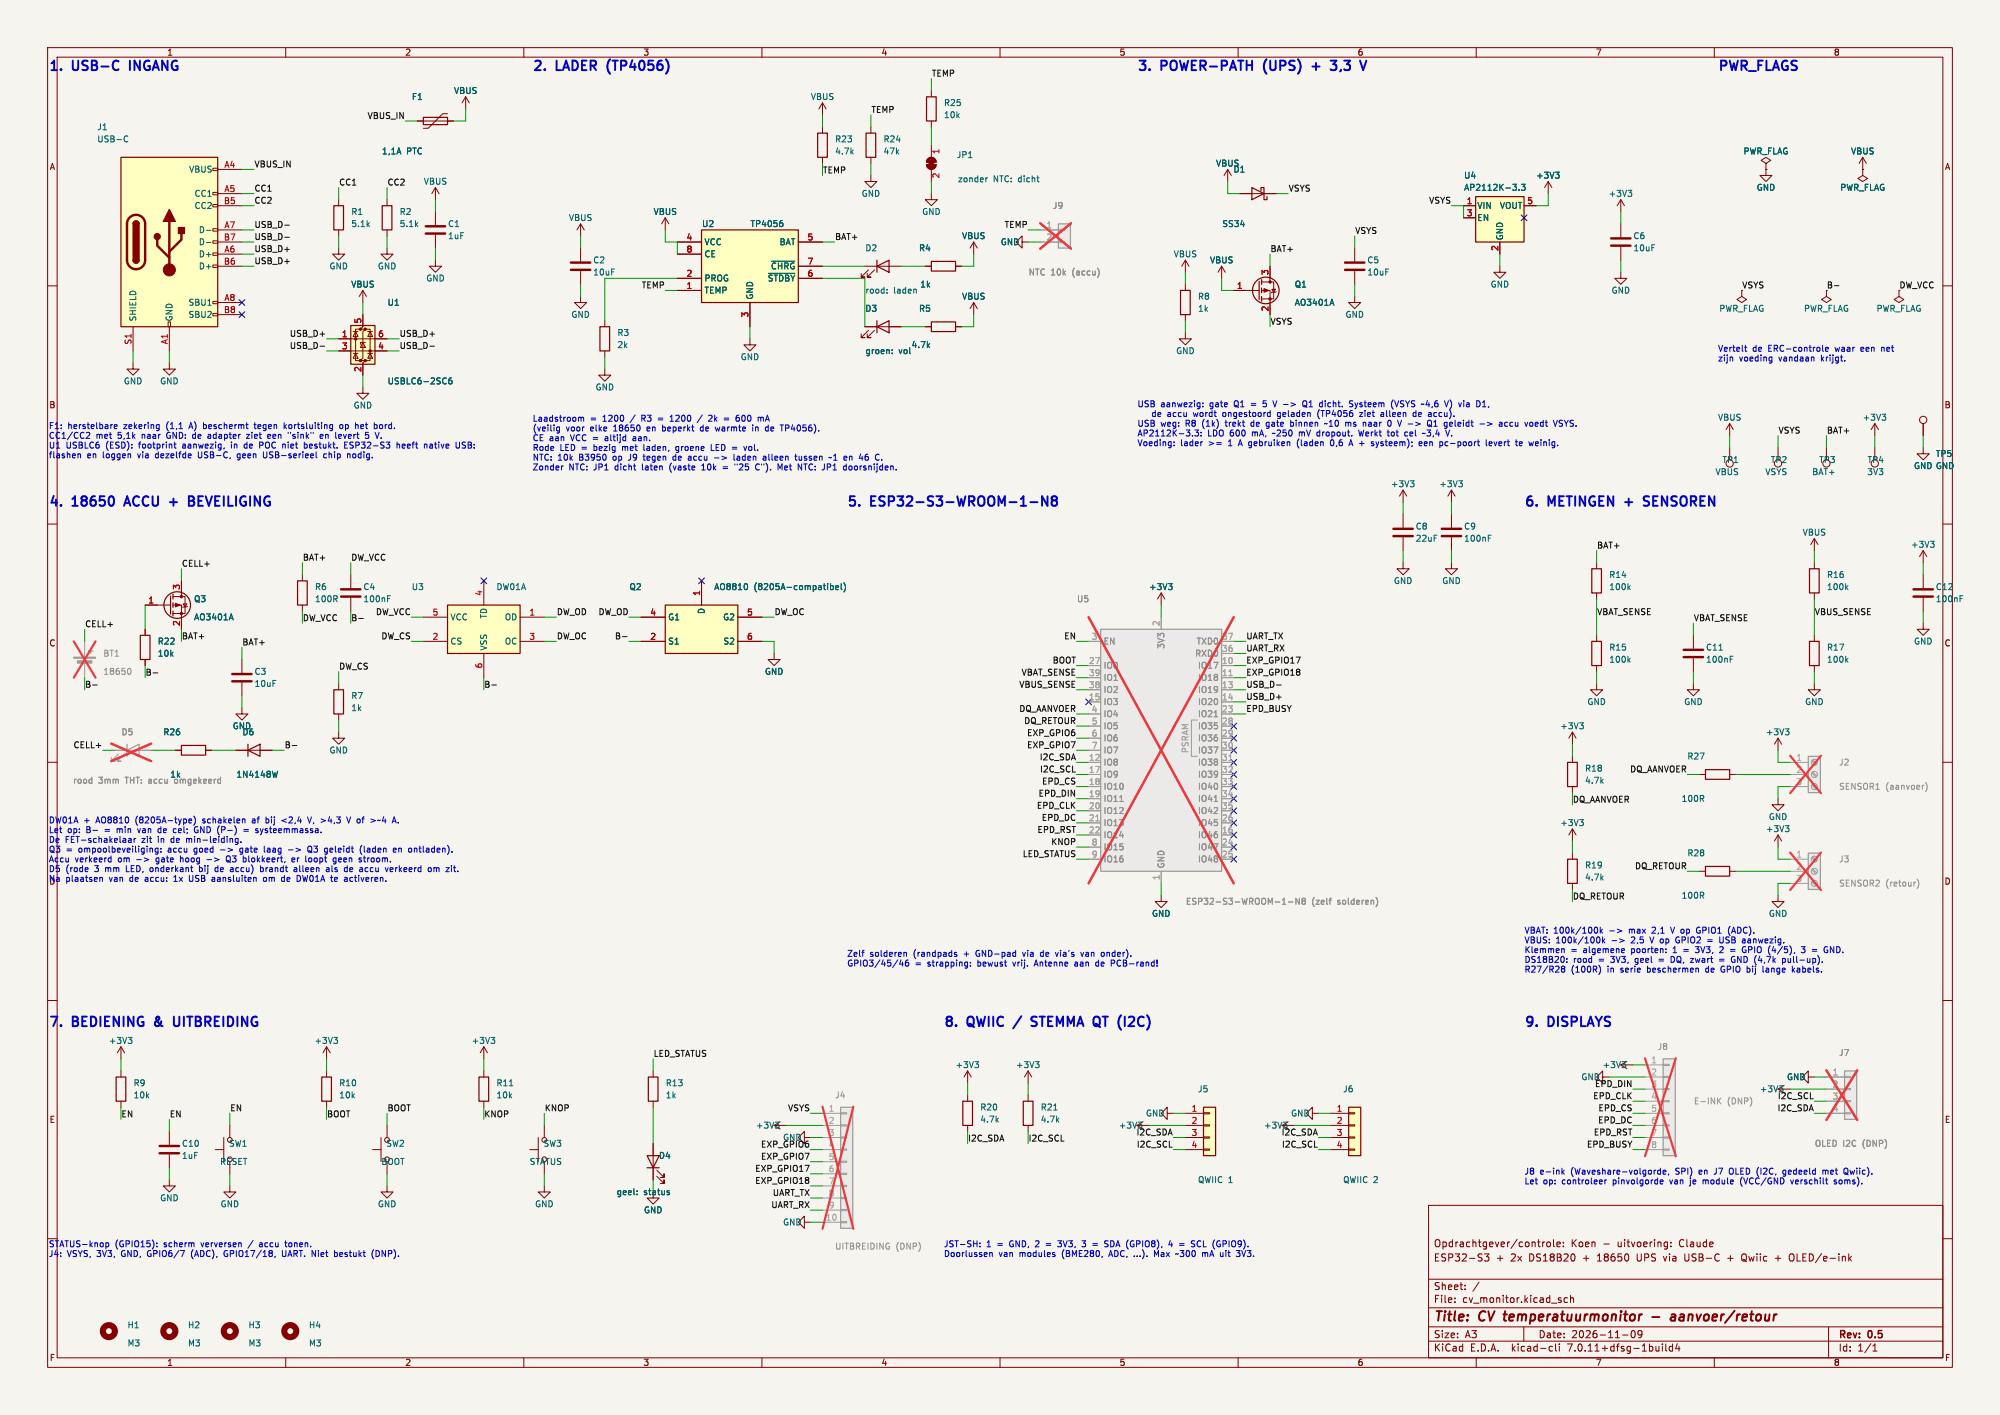
[picture p39: page 1]

zonder NTC: dicht GND

3 VCC 4 BAT 5 ~{STDBY}6 ~{CHRG} 7 CE 8 U2 TP4056 BT1

3 VCC 4 BAT 5 ~{STDBY}6 ~{CHRG} 7 CE 8 R22
