rokoter/cv-monitor/(list of files, drawings)

Other design files:
hardware/cv_monitor/cv_monitor.dsn
