rokoter/cv-monitor/hardware/cv_monitor/cv_monitor.kicad_pcb

## KiCad design hardware/cv_monitor/cv_monitor.kicad_pcb (2026-11-11)

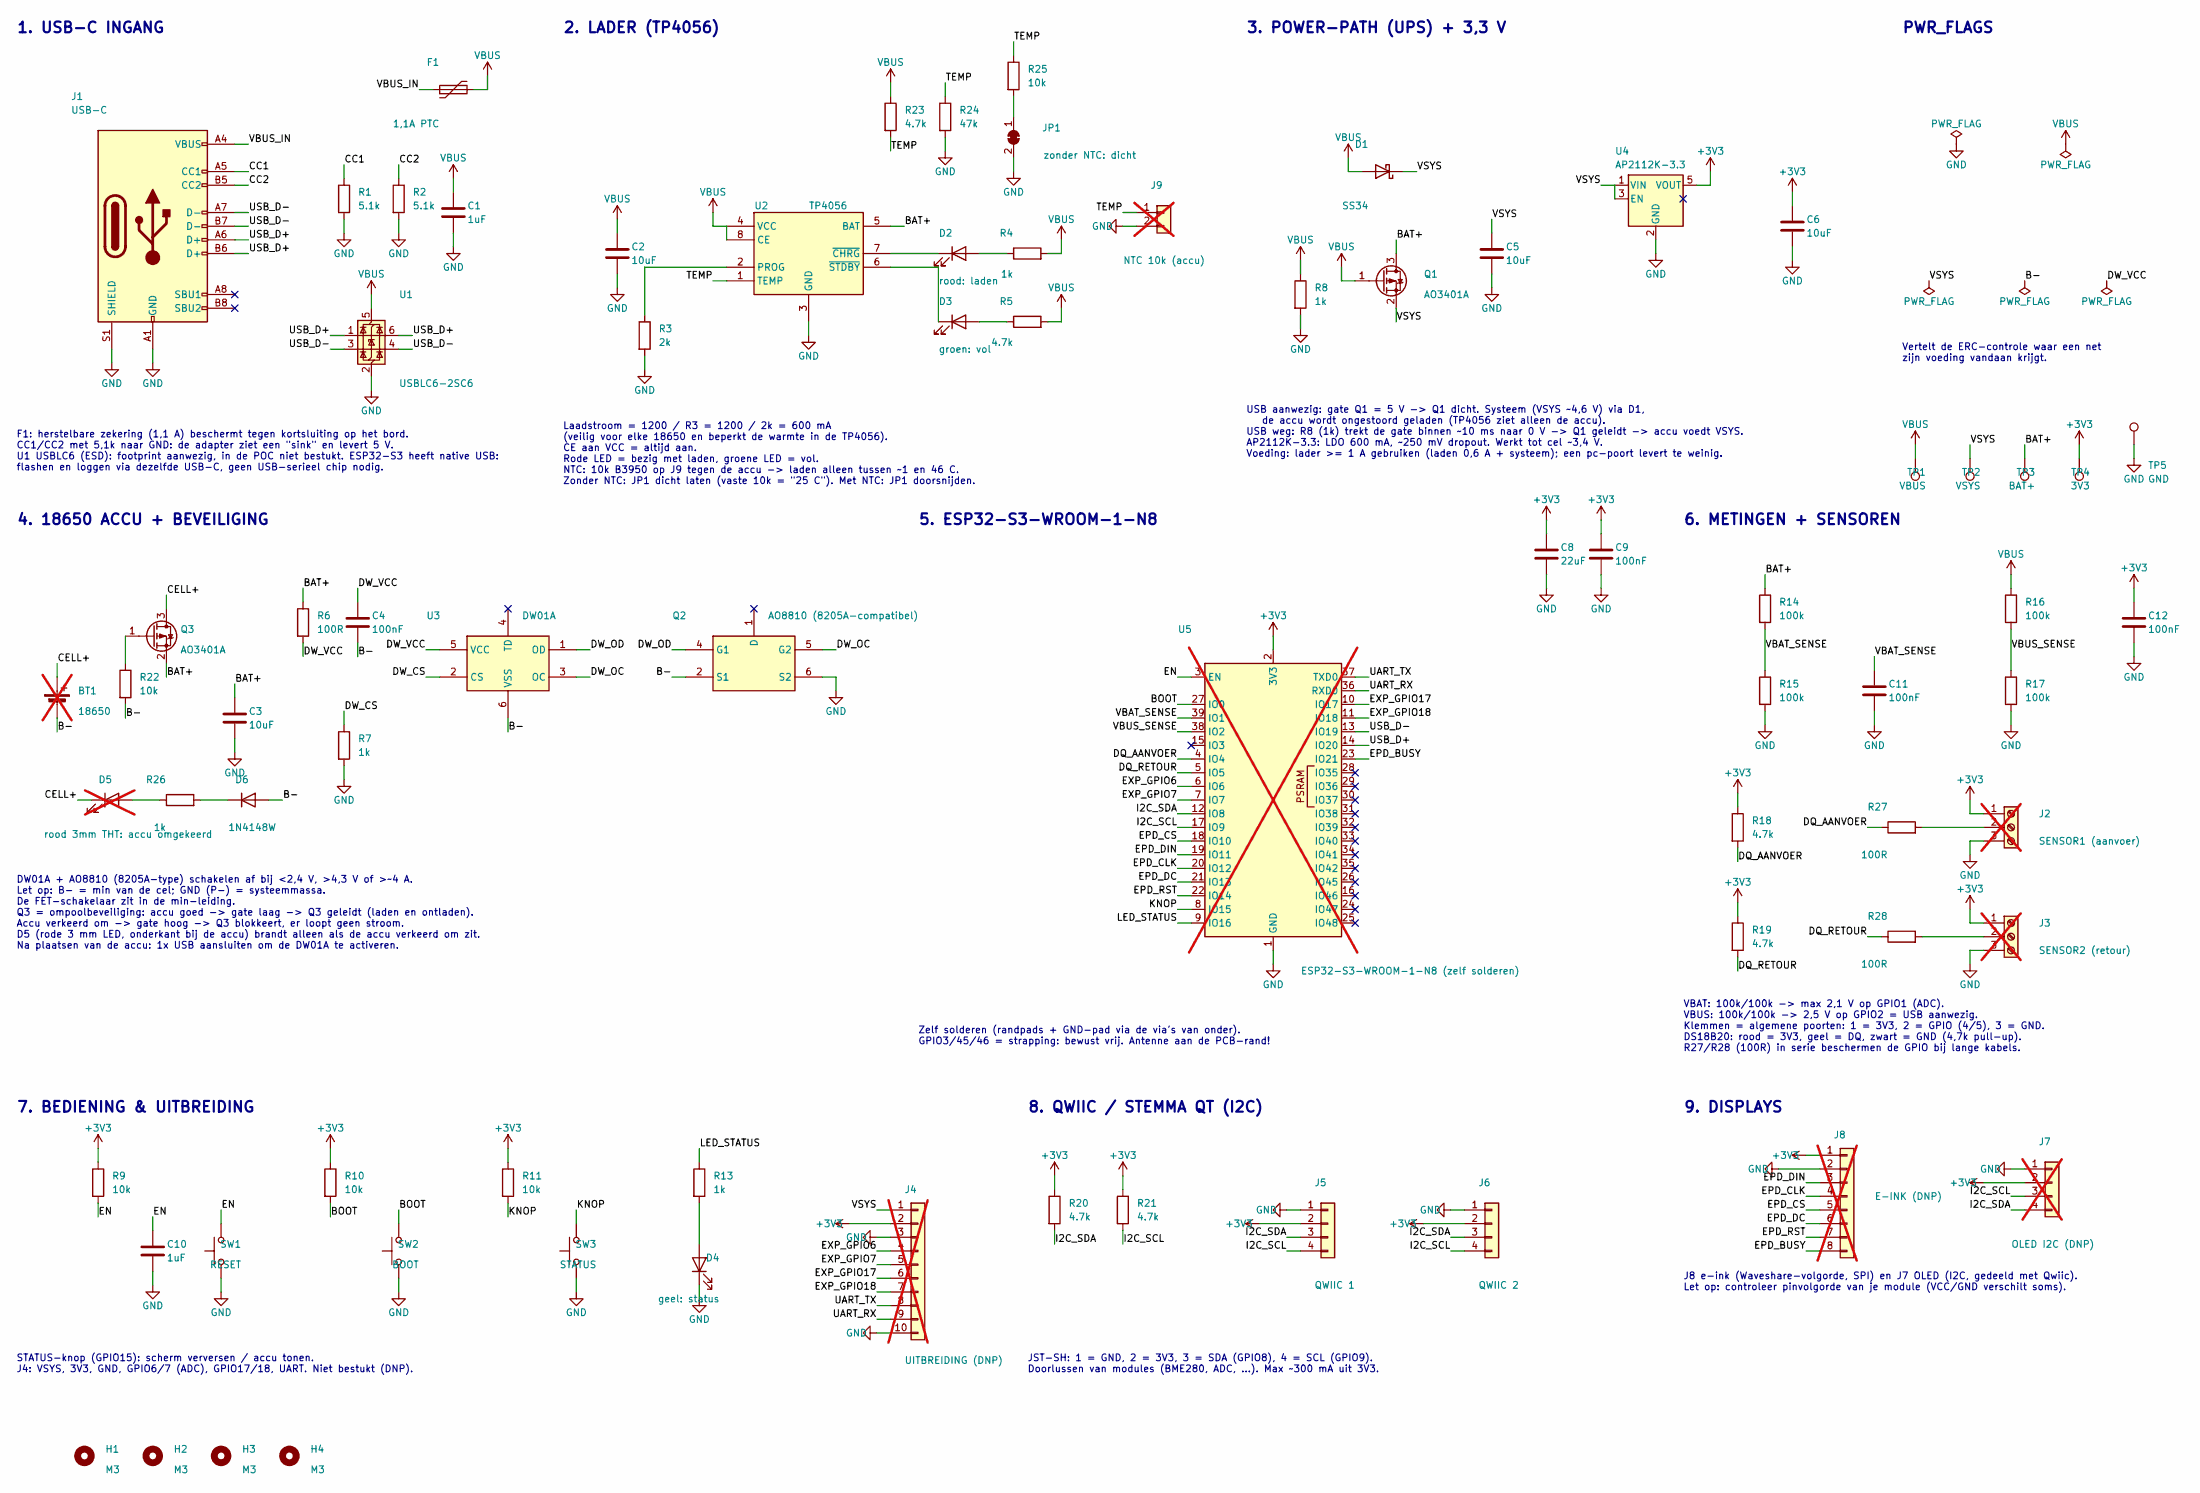
[picture p40: schematic cv_monitor.kicad_sch, CV temperatuurmonitor - aanvoer/retour]

Parts:
BT1: 18650; BatteryHolder_MPD_BH-18650-PC2; MPN houder MPD BK-18650-PC2; not fitted
C1, C10: 1uF; C_0603_1608Metric; LCSC C15849
C2, C3, C5, C6: 10uF; C_0805_2012Metric; LCSC C15850
C4, C9, C11, C12: 100nF; C_0603_1608Metric; LCSC C14663
C8: 22uF; C_0805_2012Metric; LCSC C45783
D1: SS34; D_SMA; LCSC C8678
D2: rood: laden; LED_0603_1608Metric; LCSC C2286
D3: groen: vol; LED_0603_1608Metric; LCSC C12624
D4: geel: status; LED_0603_1608Metric; LCSC C89811
D5: rood 3mm THT: accu omgekeerd; LED_D3.0mm; not fitted
D6: 1N4148W; D_SOD-123; LCSC C81598
F1: 1,1A PTC; Fuse_1206_3216Metric; LCSC C269119
H1, H2, H3, H4: M3; MountingHole_3.2mm_M3
J1: USB-C; USB_C_Receptacle_HRO_TYPE-C-31-M-12; LCSC C165948
J2: SENSOR1 (aanvoer); TerminalBlock_Phoenix_PT-1,5-3-3.5-H_1x03_P3.50mm_Horizontal; not fitted
J3: SENSOR2 (retour); TerminalBlock_Phoenix_PT-1,5-3-3.5-H_1x03_P3.50mm_Horizontal; not fitted
J4: UITBREIDING (DNP); PinHeader_1x10_P2.54mm_Vertical; not fitted
J5: QWIIC 1; JST_SH_SM04B-SRSS-TB_1x04-1MP_P1.00mm_Horizontal; LCSC C160404
J6: QWIIC 2; JST_SH_SM04B-SRSS-TB_1x04-1MP_P1.00mm_Horizontal; LCSC C160404
J7: OLED I2C (DNP); PinHeader_1x04_P2.54mm_Vertical; not fitted
J8: E-INK (DNP); PinHeader_1x08_P2.54mm_Vertical; not fitted
J9: NTC 10k (accu); JST_PH_B2B-PH-K_1x02_P2.00mm_Vertical; not fitted
JP1: zonder NTC: dicht; SolderJumper-2_P1.3mm_Bridged_RoundedPad1.0x1.5mm
Q1, Q3: AO3401A; SOT-23; LCSC C15127
Q2: AO8810 (8205A-compatibel); TSSOP-8_4.4x3mm_P0.65mm; LCSC C21426
R1, R2: 5.1k; R_0603_1608Metric; LCSC C23186
R3: 2k; R_0603_1608Metric; LCSC C22975
R4, R7, R8, R13, R26: 1k; R_0603_1608Metric; LCSC C21190
R5, R18, R19, R20, R21, R23: 4.7k; R_0603_1608Metric; LCSC C23162
R6, R27, R28: 100R; R_0603_1608Metric; LCSC C22775
R9, R10, R11, R22, R25: 10k; R_0603_1608Metric; LCSC C25804
R14, R15, R16, R17: 100k; R_0603_1608Metric; LCSC C25803
R24: 47k; R_0603_1608Metric; LCSC C25819
SW1: RESET; SW_Push_1P1T_XKB_TS-1187A; LCSC C318884
SW2: BOOT; SW_Push_1P1T_XKB_TS-1187A; LCSC C318884
SW3: STATUS; SW_Push_1P1T_XKB_TS-1187A; LCSC C318884
TP1: VBUS; TestPoint_Pad_D1.5mm
TP2: VSYS; TestPoint_Pad_D1.5mm
TP3: BAT+; TestPoint_Pad_D1.5mm
TP4: 3V3; TestPoint_Pad_D1.5mm
TP5: GND; TestPoint_Pad_D1.5mm
U1: USBLC6-2SC6; SOT-23-6; LCSC C7519
U2: TP4056; SOIC-8-1EP_3.9x4.9mm_P1.27mm_EP2.41x3.3mm_ThermalVias_0.3mm; LCSC C16581
U3: DW01A; SOT-23-6; LCSC C351410
U4: AP2112K-3.3; SOT-23-5; LCSC C51118
U5: ESP32-S3-WROOM-1-N8 (zelf solderen); ESP32-S3-WROOM-1_HandSolder; LCSC C2913198; not fitted

Connections:
+3V3: C6.1, C8.1, C9.1, C12.1, J2.1, J3.1, J4.2, J5.2, J6.2, J7.2, J8.1, R9.1, R10.1, R11.1, R18.1, R19.1, R20.1, R21.1, TP4.1, U4.5 (VOUT), U5.2 (3V3)
B-: BT1.2 (-), C4.2, D6.2 (A), Q2.2 (S1), Q2.3 (S1), R22.2, U3.6 (VSS)
BAT+: C3.1, Q1.3 (D), Q3.2 (S), R6.1, R14.1, TP3.1, U2.5 (BAT)
BOOT: R10.2, SW2.2, U5.27 (IO0)
CC1: J1.A5 (CC1), R1.1
CC2: J1.B5 (CC2), R2.1
CELL+: BT1.1 (+), D5.1 (K), Q3.3 (D)
DQ_AANVOER: R18.2, R27.1, U5.4 (IO4)
DQ_RETOUR: R19.2, R28.1, U5.5 (IO5)
DW_CS: R7.1, U3.2 (CS)
DW_OC: Q2.5 (G2), U3.3 (OC)
DW_OD: Q2.4 (G1), U3.1 (OD)
DW_VCC: C4.1, R6.2, U3.5 (VCC)
EN: C10.1, R9.2, SW1.2, U5.3 (EN)
EPD_BUSY: J8.8, U5.23 (IO21)
EPD_CLK: J8.4, U5.20 (IO12)
EPD_CS: J8.5, U5.18 (IO10)
EPD_DC: J8.6, U5.21 (IO13)
EPD_DIN: J8.3, U5.19 (IO11)
EPD_RST: J8.7, U5.22 (IO14)
EXP_GPIO6: J4.4, U5.6 (IO6)
EXP_GPIO7: J4.5, U5.7 (IO7)
EXP_GPIO17: J4.6, U5.10 (IO17)
EXP_GPIO18: J4.7, U5.11 (IO18)
GND: C1.2, C2.2, C3.2, C5.2, C6.2, C8.2, C9.2, C10.2, C11.2, C12.2, D4.1 (K), J1.A1 (GND), J1.A12 (GND), J1.B1 (GND), J1.B12 (GND), J1.S1 (SHIELD), J2.3, J3.3, J4.3, J4.10, J5.1, J6.1, J7.1, J8.2, J9.2, JP1.2 (B), Q2.6 (S2), Q2.7 (S2), R1.2, R2.2, R3.2, R7.2, R8.2, R15.2, R17.2, R24.2, SW1.1, SW2.1, SW3.1, TP5.1, U1.2 (GND), U2.3 (GND), U2.9 (EP), U4.2 (GND), U5.1 (GND), U5.40 (GND), U5.41 (GND)
I2C_SCL: J5.4, J6.4, J7.3, R21.2, U5.17 (IO9)
I2C_SDA: J5.3, J6.3, J7.4, R20.2, U5.12 (IO8)
KNOP: R11.2, SW3.2, U5.8 (IO15)
LED_STATUS: R13.1, U5.9 (IO16)
unnamed: D2.2 (A), R4.1
unnamed: D2.1 (K), U2.7 (~CHRG)
unnamed: D3.2 (A), R5.1
unnamed: D3.1 (K), U2.6 (~STDBY)
unnamed: D4.2 (A), R13.2
unnamed: D5.2 (A), R26.1
unnamed: D6.1 (K), R26.2
unnamed: J2.2, R27.2
unnamed: J3.2, R28.2
unnamed: JP1.1 (A), R25.2
unnamed: Q3.1 (G), R22.1
unnamed: R3.1, U2.2 (PROG)
TEMP: J9.1, R23.2, R24.1, R25.1, U2.1 (TEMP)
UART_RX: J4.9, U5.36 (RXD0)
UART_TX: J4.8, U5.37 (TXD0)
USB_D+: J1.A6 (D+), J1.B6 (D+), U1.1 (I/O1), U1.6 (I/O1), U5.14 (IO20)
USB_D-: J1.A7 (D-), J1.B7 (D-), U1.3 (I/O2), U1.4 (I/O2), U5.13 (IO19)
VBAT_SENSE: C11.1, R14.2, R15.1, U5.39 (IO1)
VBUS: C1.1, C2.1, D1.2 (A), F1.2, Q1.1 (G), R4.2, R5.2, R8.1, R16.1, R23.1, TP1.1, U1.5 (VBUS), U2.4 (VCC), U2.8 (CE)
VBUS_IN: F1.1, J1.A4 (VBUS), J1.A9 (VBUS), J1.B4 (VBUS), J1.B9 (VBUS)
VBUS_SENSE: R16.2, R17.1, U5.38 (IO2)
VSYS: C5.1, D1.1 (K), J4.1, Q1.2 (S), TP2.1, U4.1 (VIN), U4.3 (EN)

Notes on the sheet:
1. USB-C INGANG
F1: herstelbare zekering (1,1 A) beschermt tegen kortsluiting op het bord. CC1/CC2 met 5,1k naar GND: de adapter ziet een "sink" en levert 5 V. U1 USBLC6 (ESD): footprint aanwezig, in de POC niet bestukt. ESP32-S3 heeft native USB: flashen en loggen via dezelfde USB-C, geen USB-serieel chip nodig.
2. LADER (TP4056)
Laadstroom = 1200 / R3 = 1200 / 2k = 600 mA (veilig voor elke 18650 en beperkt de warmte in de TP4056). CE aan VCC = altijd aan. Rode LED = bezig met laden, groene LED = vol. NTC: 10k B3950 op J9 tegen de accu -> laden alleen tussen ~1 en 46 C. Zonder NTC: JP1 dicht laten (vaste 10k = "25 C"). Met 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
3. POWER-PATH (UPS) + 3,3 V
USB aanwezig: gate Q1 = 5 V -> Q1 dicht. Systeem (VSYS ~4,6 V) via D1, de accu wordt ongestoord geladen (TP4056 ziet alleen de accu). USB weg: R8 (1k) trekt de gate binnen ~10 ms naar 0 V -> Q1 geleidt -> accu voedt VSYS. AP2112K-3.3: LDO 600 mA, ~250 mV dropout. Werkt tot cel ~3,4 V. Voeding: lade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
PWR_FLAGS
Vertelt de ERC-controle waar een net zijn voeding vandaan krijgt.
4. 18650 ACCU + BEVEILIGING
DW01A + AO8810 (8205A-type) schakelen af bij <2,4 V, >4,3 V of >~4 A. Let op: B- = min van de cel; GND (P-) = systeemmassa. De FET-schakelaar zit in de min-leiding. Q3 = ompoolbeveiliging: accu goed -> gate laag -> Q3 geleidt (laden en ontladen). Accu verkeerd om -> gate hoog -> Q3 blokkeert, er lo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
5. ESP32-S3-WROOM-1-N8
Zelf solderen (randpads + GND-pad via de via's van onder). GPIO3/45/46 = strapping: bewust vrij. Antenne aan de PCB-rand!
6. METINGEN + SENSOREN
VBAT: 100k/100k -> max 2,1 V op GPIO1 (ADC). VBUS: 100k/100k -> 2,5 V op GPIO2 = USB aanwezig. Klemmen = algemene poorten: 1 = 3V3, 2 = GPIO (4/5), 3 = GND. DS18B20: rood = 3V3, geel = DQ, zwart = GND (4,7k pull-up). R27/R28 (100R) in serie beschermen de GPIO bij lange kabels.
7. BEDIENING & UITBREIDING
STATUS-knop (GPIO15): scherm verversen / accu tonen. J4: VSYS, 3V3, GND, GPIO6/7 (ADC), GPIO17/18, UART. Niet bestukt (DNP).
8. QWIIC / STEMMA QT (I2C)
JST-SH: 1 = GND, 2 = 3V3, 3 = SDA (GPIO8), 4 = SCL (GPIO9). Doorlussen van modules (BME280, ADC, ...). Max ~300 mA uit 3V3.
9. DISPLAYS
J8 e-ink (Waveshare-volgorde, SPI) en J7 OLED (I2C, gedeeld met Qwiic). Let op: controleer pinvolgorde van je module (VCC/GND verschilt soms).

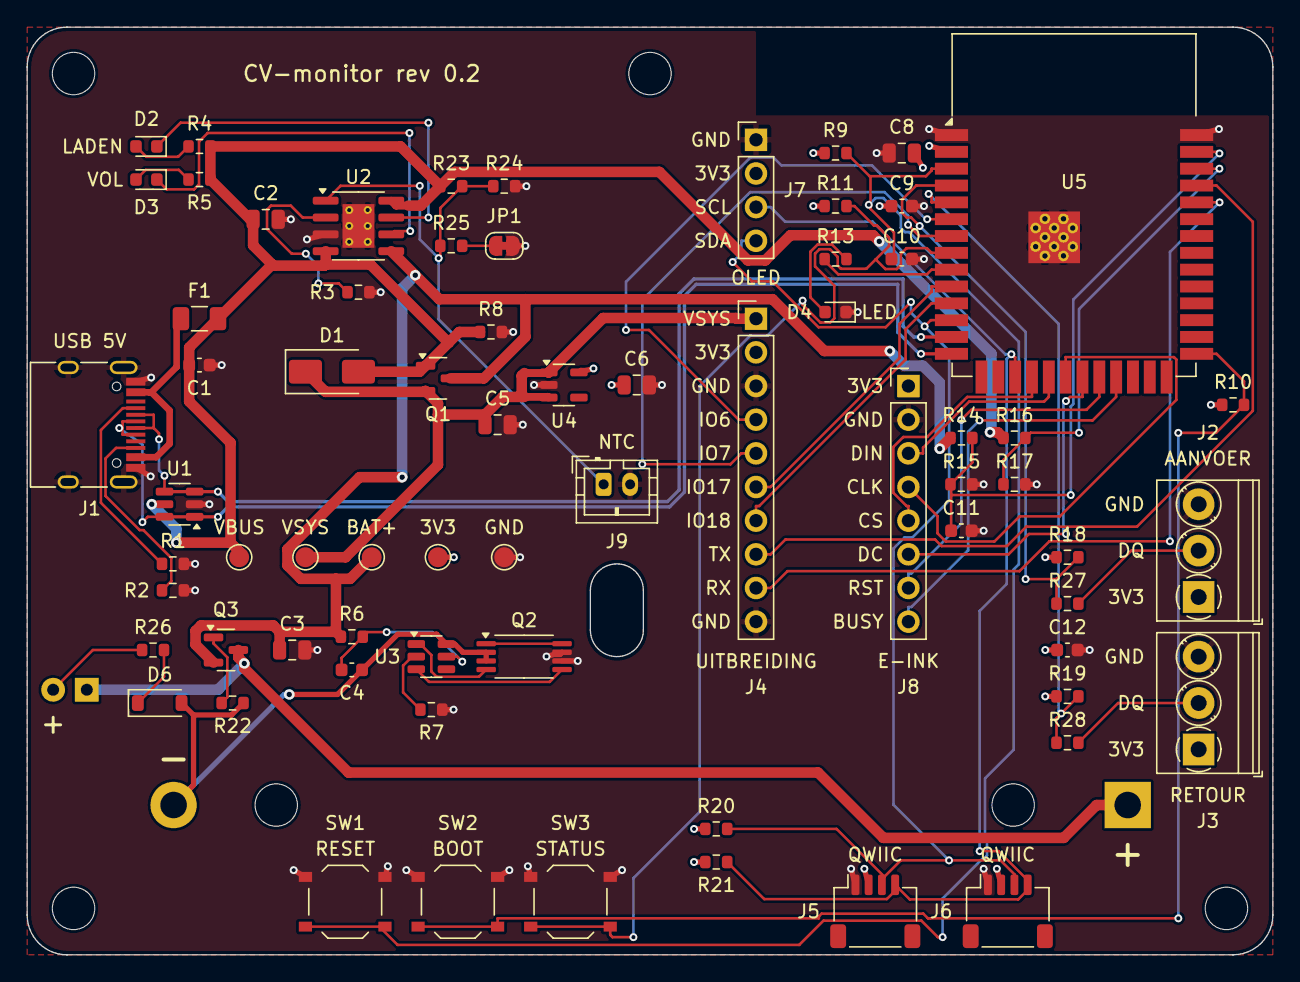
[picture p41: board cv_monitor.kicad_pcb from above]

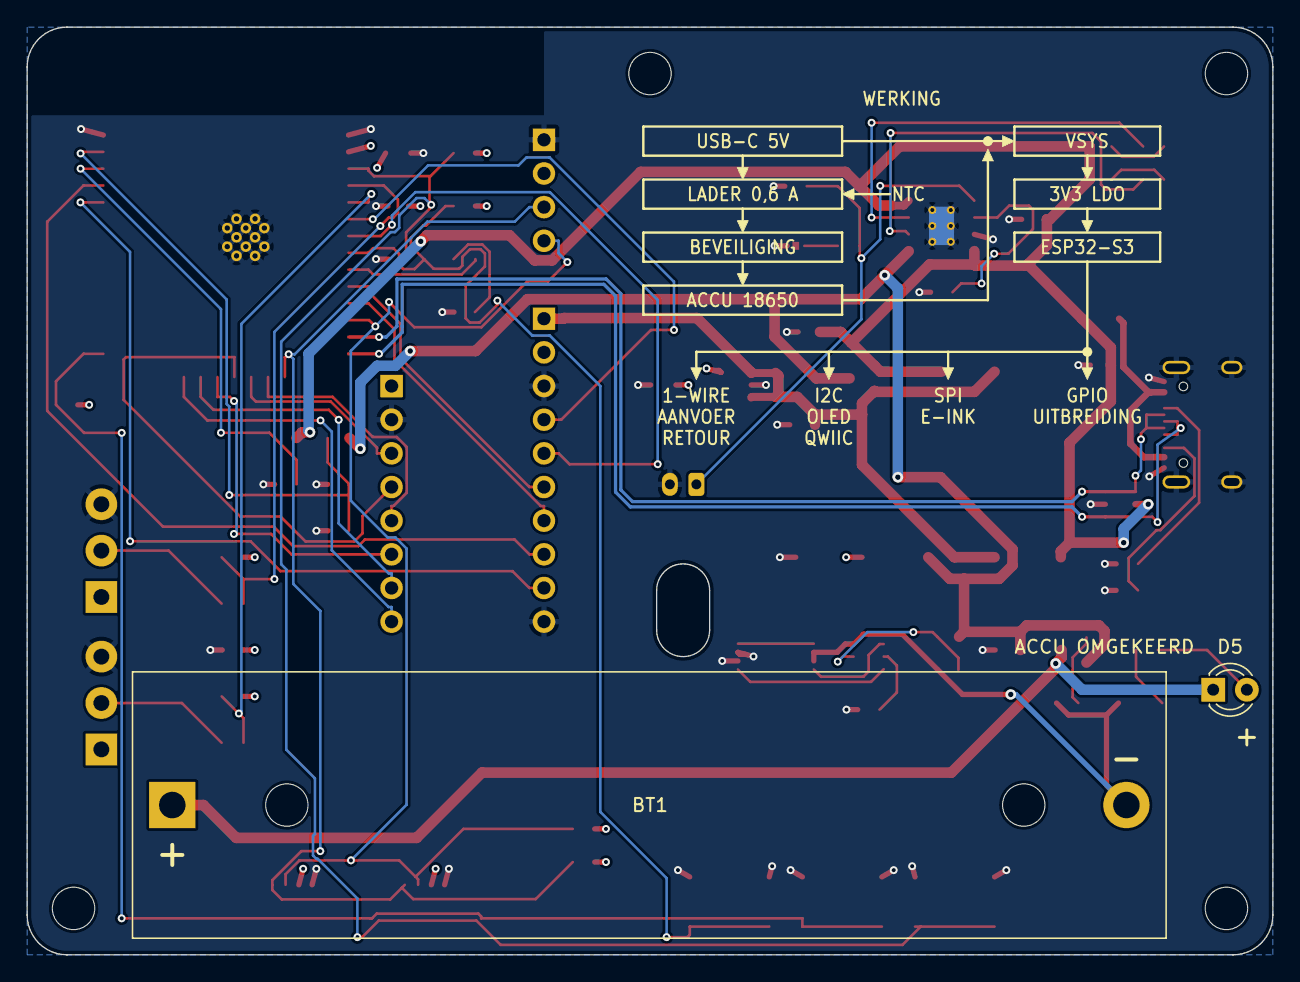
[picture p42: board cv_monitor.kicad_pcb from below]

Board: 4 copper layers, 94.0 x 70.0 mm, 76 parts (2 on the bottom side), 51 nets.
