rokoter/cv-monitor/(commit log)

2026-11-09 Schema rev 0.4: basis van het project
    ESP32-S3-MINI-1-N8 sensorbord met USB-C (PTC, ESD), TP4056-lader met
    optionele NTC, power-path (UPS) met 18650, ompoolbeveiliging + fout-LED,
    DW01A/FS8205A accubeveiliging, 2 sensorpoorten, Qwiic, OLED- en
    e-ink-aansluiting. Inclusief generator- en controlescripts en draw.io-uitleg.
    Claude-Session: https://claude.ai/code/session_019BuDoaGkboDRBM2cBikXqr
    [cv_monitor.kicad_sch]
2026-11-09 Schema rev 0.5: BOM geoptimaliseerd voor JLCPCB-assemblage
    - Qwiic: LCSC C160390 (verticaal, paste niet) -> C160404 (liggend)
    - 8205A: uitverkochte C32254 -> HXY C5148694 (zelfde TSSOP-8 pinout)
    - Accuhouder (THT BH-18650-PC2), sensorklemmen, NTC-connector (THT PH)
    en headers: zelf solderen, uit de JLCPCB-BOM
    - VBUS-deler 68k/100k -> 100k/100k (een unieke BOM-regel minder)
    - docs/BOM_JLCPCB.md: overzicht basic/extended per onderdeel
    - README: KiCad-versiebeleid
    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
    [cv_monitor.kicad_sch]
2026-11-09 Schema rev 0.6: goedkoopste POC-variant (JLCPCB Economic PCBA)
    - ESP32-S3-MINI-1 -> ESP32-S3-WROOM-1-N8 (KiCad-standaardsymbool en
    -footprint met via's in het GND-pad), zelf solderen: alle ESP-modules
    zijn bij JLCPCB 'Standard only', zonder module kan Economic
    - USBLC6 (ESD) en Qwiic-connectoren: footprint blijft, niet bestukt (DNP)
    - Eigen ESP-symbool en -footprint verwijderd (niet meer nodig)
    - JLCPCB-BOM: 25 regels, 6 extended
    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
    [cv_monitor.kicad_sch]
2026-11-09 Schema rev 0.7: verwerking review
    - R8 10k -> 1k en C1 10uF -> 1uF: na USB-uitval schakelt Q1 binnen
    ~10 ms naar de accu (was ~90 ms via de body-diode, 3V3 kon dippen)
    - R27/R28 100R in serie met de sensorpoorten (bescherming GPIO)
    - Testpunten TP1-TP5 (VBUS, VSYS, BAT+, 3V3, GND), alleen koperpads
    - Accuhouder vastgelegd: MPD BK-18650-PC2 (enige houder die op de footprint past)
    - Notities: DW01A-activering, lader >= 1 A
    - Nieuwe controle: check_footprints.py (symboolpinnen <-> footprintpads)
    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
    [cv_monitor.kicad_sch]
2026-11-09 PCB: eerste plaatsing (rev 0.1) ter review
    - make_pcb.py: bord uit de KiCad-netlist, footprints gekoppeld aan
    schemasymbolen (UUID), DNP/BOM-attributen, afgeronde contour 94x70 mm
    - placement.py: plaatsing; 18650-houder aan de onderkant, ESP rechtsboven
    met antenne aan de rand, connectoren aan de randen
    - Projectfootprints: ESP32-S3-WROOM-1 handsoldeervariant (langere pads,
    0,4 mm GND-via's), TP4056 met 0,3 mm thermische via's (JLCPCB-standaard)
    - Bevestigingsgaten H1-H4 (M3) in schema en PCB
    - render_pcb.py (review-plaatje met ratsnest), drc.py (KiCad-DRC via Python)
    Claude-Session: https://claude.ai/code/session_019BuDoaGkboDRB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
    [cv_monitor.kicad_pcb, cv_monitor.kicad_sch]
2026-11-09 PCB rev 0.2: silkscreen, THT-botsing accuhouder, 4 lagen
    Feedback Koen verwerkt:
    - J9 (NTC) en J7 (OLED) waren THT boven de accuhouder aan de onderkant:
    verplaatst. Nieuwe controle pcb_checks.py: THT-pinnen/gaten tegen
    courtyards van onderdelen aan de andere zijde (vangt de KiCad-DRC niet)
    - Silkscreen: automatische plaatsing van referenties (silk.py), 1,0 mm,
    binnen de bordrand, niet over pads/gaten/teksten/andere onderdelen;
    waarden (fab-laag) verborgen; testpunten gelabeld met netnaam
    - ESP 0,65 mm en USB-C gelijk met de rand: geen silk over de bordrand
    - Bord naar 4 lagen (F.Cu | In1 GND | In2 voeding | B.Cu)
    - render_preview.py: realistische preview (masker, silk, pads)
    DRC: 0 s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
    [cv_monitor.kicad_pcb]
2026-11-09 PCB rev 0.2: functielabels (boven) en pinbenamingen (onder) op silkscreen
    - Bovenkant: RESET/BOOT/STATUS, LADEN/VOL/LED/ACCU OMGEKEERD, USB 5V,
    AANVOER/RETOUR, E-INK, OLED, UITBREIDING, QWIIC, NTC
    - Onderkant: pinnamen bij J2, J3, J4, J7, J8 en J9
    - silk.py: plaatser werkt nu per zijde en kan labels per pin plaatsen
    - Sensorklemmen 0,6 mm van de rand (ruimte voor pinlabels onderkant)
    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
    [cv_monitor.kicad_pcb]
2026-11-09 PCB rev 0.2: accu-fout-LED aan de accukant, knoplabels op één lijn
    - D5 wordt een 3 mm THT-LED (zelf solderen) aan de onderkant, naast de
    accuhouder, met label ACCU OMGEKEERD op de onderkant. R26/D6 ernaast.
    Eén JLCPCB-plaatsing minder (D5 was SMD).
    - R11 (pull-up STATUS-knop, GPIO15) naar de ESP; knoplabels RESET/BOOT/
    STATUS vast recht boven de knoppen (FUNC_LABEL_DIR)
    - silk.py: plaatsing per zijde incl. functielabels aan de onderkant
    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
    [cv_monitor.kicad_pcb, cv_monitor.kicad_sch]
2026-11-10 PCB rev 0.2: alle passieven horizontaal, alle silkscreen-tekst op 0°
    - R/C/D/F-onderdelen horizontaal; ESP-randcomponenten en TEMP-netwerk in rasters
    - knoppen naar rechts (vrij van de accugaten), referentie boven het functielabel
    - footprintteksten absoluut op 0° (KiCad 7 slaat de hoek relatief op)
    - e-ink pinlabels (onder) horizontaal in twee verspringende rijen
    - drc.py controleert nu ook silk-hoek en oriëntatie van passieven
    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
    [cv_monitor.kicad_pcb]
2026-11-10 PCB rev 0.2: pinnamen op de bovenkant, + bij accu-omgekeerd-LED
    - J4 (uitbreiding) en J8 (e-ink) verticaal, pinnamen links van elke pin, één per regel
    - J7 (OLED) en klemmen J2/J3 ook met pinnamen op de bovenkant
    - functielabel + referentie gestapeld onder/boven de connectoren
    - '+' bij de anode van D5 (boven- en onderkant)
    - metingen en sensorweerstanden opnieuw in rasters; klemmen 2,5 mm omhoog (vrij van accupad)
    - silk.py: pinnamen eerst plaatsen, precieze courtyard-test voor de T-vormige ESP-courtyard
    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
    [cv_monitor.kicad_pcb]
2026-11-10 PCB rev 0.2: doorvoersleuf voor de accu-NTC
    - sleuf 4 x 7 mm (Edge.Cuts) naast het midden van de accuhouder
    - NTC-connector J9 direct boven de sleuf (bovenkant), Q2 1 mm opgeschoven
    - silk.py: uitsparingen binnen het bord gelden als obstakel (0,5 mm vrij)
    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
    [cv_monitor.kicad_pcb]
2026-11-10 PCB rev 0.2: NTC-sleuf verticaal uitgelijnd op J9
    De sleuf neemt nu automatisch het midden van de J9-behuizing over (x 44,5 mm).
    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
    [cv_monitor.kicad_pcb]
2026-11-10 PCB rev 0.2: titel bovenaan tussen montagegaten H1 en H4
    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
    [cv_monitor.kicad_pcb]
2026-11-10 PCB rev 0.2: blokschema van de werking op de achterkant
    USB-C -> lader (NTC) -> beveiliging -> accu; USB en accu samen naar VSYS -> 3V3 -> ESP32-S3
    -> 1-wire (aanvoer/retour), I2C (OLED/Qwiic), SPI (e-ink), GPIO (uitbreiding).
    Getekend in achteraanzicht-coördinaten en gespiegeld (generator/back_diagram.py).
    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
    [cv_monitor.kicad_pcb]
2026-11-10 PCB rev 0.2: headers uitgelijnd
    - J7 (OLED) en J4 (uitbreiding) op één verticale lijn (x 55 mm), pinnamen in één kolom
    - J8 (e-ink) onderaan gelijk met J4, op hetzelfde 2,54-mm-raster; functielabels en referenties op één lijn
    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
    [cv_monitor.kicad_pcb]
2026-11-10 3D-modellen in de repo; alle footprints in de projectbibliotheek
    - 24 STEP-modellen in hardware/cv_monitor/3dmodels (KiCad 7.0.11 + JST-SH uit 10.0.7)
    - zelf gegenereerd (make_3dmodels.py): HRO USB-C, XKB TS-1187A drukknop, 18650-cel in de houder
    - alle gebruikte footprints in cv_monitor.pretty met ${KIPRJMOD}/3dmodels-paden:
    project werkt in elke KiCad-versie zonder bibliotheekafwijkingen (DRC 0)
    - schema: footprintvelden naar cv_monitor:… (verder ongewijzigd, netlist 0 fouten)
    - render_3d.py: eenvoudige z-buffer-preview van het STEP-bord
    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
    [BatteryHolder_MPD_BH-18650-PC2.step, C_0603_1608Metric.step, C_0805_2012Metric.step, Cell_18650.step, D_SMA.step, D_SOD-123.step, ESP32-S3-WROOM-1.step, Fuse_1206_3216Metric.step]
2026-11-10 Routing voorbereid: ontwerpregels, netklassen, binnenvlakken, DSN-export
    - netklassen: Default 0,2/0,15 mm, Power 0,5 mm (USB 5V, VSYS, accu), Batt 0,4 mm (B-), Supply 0,4 mm (GND, 3V3)
    - In1 = GND-vlak, In2 = 3V3-vlak (laagtype power), antenne-keepout ook op In2
    - generator/route.py: prep (vlakken + DSN) en import (SES + GND-vulling boven/onder)
    - hardware/cv_monitor/cv_monitor.dsn voor Freerouting
    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
    [cv_monitor.dsn, cv_monitor.kicad_pcb]
2026-11-10 PCB rev 0.2: eerste volledige routing (Freerouting) - DRC 0, 0 open verbindingen
    - route.py prep: In1 GND / In2 3V3, keepouts (antenne op alle lagen, bovenlaag onder de ESP,
    NTC-sleuf met randafstand), fanout van 54 GND/3V3-pads naar de vlakken (fanout.py),
    vaste USB-C D+/D- verbindingen; import: eigen SES-lezer (KiCad 7 kan dat alleen in de editor),
    GND-vulling boven/onder, geen vulling rond de JP1-brug
    - rules.py: netklassen (Power 0,8 mm, USB-ingang 0,5 mm, B- 0,4 mm, Supply 0,4 mm, standaard 0,2/0,15)
    - route_report.py: lengtes/breedtes per net + controles; render_layers.sh: koperlagen als PNG
    - generator/freerouting.rules: fanout aan; cv_monitor.dsn/.ses in de repo
    Co-Authored-By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
    [cv_monitor.dsn, cv_monitor.kicad_pcb]
2026-11-10 USB D+/D- als differentieel paar; opruimen na autorouting
    - netklasse USB (0,25/0,15 mm, ~90 ohm schatting); paar vast voorgerouteerd van U1 naar ESP-pin 13/14
    over de onderkant (79,6 / 79,2 mm, 2 via's per lijn), U1 180° gedraaid (geen kruising nodig)
    - USB-C: D- via de onderkant zodat VBUS-pin A9 vrij is; U1-VBUS-pin met eigen via
    - C8 180° gedraaid: 3V3-kant naar de ESP-voedingspin (pin 2 -> C8 -> vlak)
    - fanout: bestaande sporen/via's als obstakel (laagbewust), terugval naar korte verbinding met een pad
    van hetzelfde net (bijv. GND-pin naar mantelpin)
    - import: piepkleine/dubbele sporen en via's op maar één laag opruimen
    - DRC 0 schendingen, 0 open verbindingen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
    [cv_monitor.dsn, cv_monitor.kicad_pcb]
2026-11-10 Productiebestanden rev 0.2 voor JLCPCB (Economic PCBA)
    - U1 (USB-ESD) en Qwiic J5/J6 door JLCPCB laten plaatsen; ESP en through-hole blijven zelf solderen
    - sync_attrs.py: LCSC/DNP uit design.py naar het gerouteerde bord zonder opnieuw te routeren
    - make_production.py: Gerber/drill-zip, BOM en CPL (oorsprong linksonder, JLC-draaiingscorrecties)
    - production/README.md: bestelchecklist, preview-controle, soldeervolgorde, eerste test
    - Gerbers onafhankelijk gecontroleerd met gerbv (docs/gerber_controle_*.png)
    - KOSTEN.md bijgewerkt voor 5 geassembleerde borden, 8 extended onderdelen
    - Geen JLCJLCJLCJLC-markering: JLCPCB drukt sinds mei 2026 geen ordernummer meer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
    [cv_monitor.kicad_pcb, cv_monitor.kicad_sch, cv_monitor_rev0.2_bom.csv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]
2026-11-11 Uitverkochte onderdelen vervangen (D3, D4, F1, Q2) + voorraadcontrole
    JLCPCB-BOM-tool meldde tekorten; controle van de hele BOM vond er nog een (Q2).
    - D3 groen: C72043 (uitverkocht, ook geen basic meer) -> C12624 KT-0603G
    - D4 blauw: C72041 (1 op voorraad) -> C2288 KT-0603B (zelfde fabrikant als rode D2)
    - F1 PTC 1,1 A: C523825 (2 op voorraad) -> C269119 Brightking SMD1206B110TFT, 8 V
    - Q2: C5148694 (niet meer in de bibliotheek) -> C21426 AO8810, pinout gelijk aan 8205A
    - jlc_check.py: controleert voorraad en Basic/Preferred/Extended met de dagelijkse jlcparts-data
    - sync_attrs.py neemt nu ook de waarde over
    - Kosten: 9 extended, alle 27 regels leverbaar (11 november 2026)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
    [cv_monitor.kicad_pcb, cv_monitor.kicad_sch, cv_monitor_rev0.2_bom.csv]
2026-11-11 CPL: SOT-23-5/-6 een kwartslag gecorrigeerd na JLCPCB-preview
    In de preview stonden U1 (USBLC6), U3 (DW01A) en U4 (AP2112K) 90 graden verdraaid:
    het JLC-model heeft de pinrijen boven/onder, onze footprint links/rechts.
    Correctie +270 (net als SOIC/TSSOP) i.p.v. +180; SOT-23 (Q1, Q3) blijft +180.
    Overige gepolariseerde onderdelen gecontroleerd en in orde.
    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
    [cv_monitor_rev0.2_cpl.csv]
2026-11-11 LED's wit (vol) en geel (status): 2 extended-onderdelen minder
    Groen en blauw 0603 zijn bij JLCPCB extended (EUR 2,76 per stuk per order).
    - D3 vol: C2290 KT-0603W (basic, zelfde fabrikant als rode D2)
    - D4 status: C89811 NCD0603Y2 (preferred, geen toeslag)
    Netnamen (LEDG/LEDB) ongewijzigd, routing en CPL-posities blijven gelijk.
    Voor de andere 7 extended onderdelen is geen basic/preferred-variant met dezelfde
    behuizing en pinout. KOSTEN.md bijgewerkt met de echte offerte.
    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
    [cv_monitor.kicad_pcb, cv_monitor.kicad_sch, cv_monitor_rev0.2_bom.csv]
2026-11-11 D3 weer groen (vol), D4 geel (status); R5 4k7 voor gelijke helderheid
    - D3: C12624 KT-0603G groen (extended, EUR 2,76 per order: kleur is het waard)
    - D4: blijft C89811 geel (preferred) i.p.v. blauw: minder fel, geen toeslag
    - R5: 1k -> 4k7 (al in de BOM): groene LED ~0,5 mA, even fel als de rode (~45 mcd)
    8 extended, alle 27 regels op voorraad.
    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
    [cv_monitor.kicad_pcb, cv_monitor.kicad_sch, cv_monitor_rev0.2_bom.csv]
