rokoter/cv-monitor/(notices)

Notices in the files:
hardware/cv_monitor/3dmodels/LED_0603_1608Metric.step:
Copyright (C) 2018, kicad StepUp
This work is licensed under the [Creative Commons CC-BY-SA 4.0 License](https://creativecommons.org/licenses/by-sa/4.0/legalcode),
with the following exception:
To the extent that the creation of electronic designs that use 'Licensed Material' can be considered to be 'Adapted Material',
You are free to use the library data in your own projects without the obligation to share your project files under this or any other license agreement.
hardware/cv_monitor/3dmodels/D_SMA.step:
Copyright (C) 2017, kicad StepUp
This program is free software: you can redistribute it and/or modify
it under the terms of the GNU General Public License as published by
the Free Software Foundation, either version 3 of the License, or
any later version.
itself might be covered by the GNU General Public License.
hardware/cv_monitor/3dmodels/Fuse_1206_3216Metric.step:
Copyright (C) 2020, kicad StepUp
hardware/cv_monitor/3dmodels/JST_PH_B2B-PH-K_1x02_P2.00mm_Vertical.step:
Copyright (C) 2017, Rene Poeschl
hardware/cv_monitor/3dmodels/JST_SH_SM04B-SRSS-TB_1x04-1MP_P1.00mm_Horizontal.step:
Copyright (C) 2025, KiCAD
This work is licensed under the
[Creative Commons CC-BY-SA 4.0 License](https://creativecommons.org/licenses/by-sa/4.0/legalcode),
project files under this or any other license agreement. However, if you wish to distribute
